Furkannn/senior-design/4. PDR/PDR - Version 1.pptx

## Head Controlled Human Interface Device for Users With Limited Hand Movement

Georgia Institute of Technology
School of Electrical and Computer Engineering
Augmented Comm Group
Roberto Pereira
Seth Stewart
Jarius Tillman
Sarvagya Vaish
March 14, 2013

## Project Overview

Human Interface Device
  - Alternative to current standard interface devices
  - Spinal cord injury or limited hand mobility patients.
Estimated Cost:

IMU | $100
Arduino | $ 50
Small Parts | $15
OFS | Donated
PCB | Donated
PLastic Housing | Donated
Total Cost | $165

Notes: Reduce wordiness to key points, speaker will elaborate
Cost ==

## Objectives

Complete prototype device:
-Fully functioning mouse movement using Pitch and Yaw head movements.
- Left and right click using facial gestures such as eyebrow raises.
- Integrate components into a small wearable device.

## Current Status

- Parts have been received
- A program has been implemented to translate the x-y displacement of the IMU (shown in video)
- 3D-printed a model to test the pcb,lens,OFS configuration
- Still working on translating the data from IMU/OFS to computer

## Video of working motion

Add video from Survy's Dropbox?

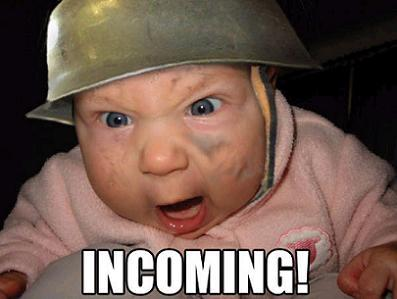
[picture p24: figure]

## Block Diagram

Block diagram from proposal

## Technical Approach

Arduino interfaces using SPI for OFS and IMU.
Retreive the x-y displacement registers on OFS at (speed).
IMU streams yaw, pitch, and roll using code. (Survy how?)
PICTURE?

## Logic Flow Chart(from proposal)

-This is how the device makes decisions to move the mouse.

## In-depth Review

Problems:
OFS part acquisition
Integrated mounting of OFS and IMU

Notes: In-depth review of the design, including problems/challenges/issues (you don’t have to present solutionsto the problems, but you can)

## Project Schedule(specific dates)

Get correct results from OFS
Get wouse code incorporated with to recognize the facial gestures
