Furkannn/senior-design/3. Project Summary Draft/Project Summary Working Draft - Augmented Comm.pdf

## ECE4007 Project Summary

Project Title | Augmented Communication Device
Team Members (names and majors) | Roberto Pereira – Computer Egineering

Seth Stewart – Computer Egineering

Jarius Tillman – Computer Egineering

Sarvagya Vaish – Computer Egineering

Advisor / Section | Dr. Arthur Koblasz – L04
Semester | 2009 Spring Intermediate or Final

Project Abstract

### (250-300 words)

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

Project Title | Augmented Communication Device

### List codes and

standards that

### significantly affect your project. Briefly describe how they influenced

your design.

| The Augmented Communication Device will make use of the following standards for general electrical safely: • OSHA 1910.335(a)(1)(iv): Employees shall wear nonconductive head protection wherever there is a danger of head injury from electric shock or burns due to contact with exposed energized parts • OSHA 1910.335(a)(1)(v): Employees shall wear protective equipment for the eyes or face wherever there is danger of injury to the eyes or face from electric arcs or flashes or from flying objects resulting from electrical explosion • With the ground wire disconnected, the chassis leakage is limited to 100 uA and the patient lead leakage must not exceed 50 uA The group decided to design a non-conductive casing for the device in order to meet these OSHA standards.
| The Augmented Communication Device will make use of the following standards for intra and inter device communication: • USB HID (Human Interface Device) Class interface for mouse communication • Inter-Integrated Circuit (I2C) protocol between the Inertial Momentum Unit and the ARM microprocessor • Serial Peripheral Interface (SPI) protocol between the optical flow sensor and the ARM microprocessor and between the ARM processor and the USB controller
| The following programming languages will be used for data processing and communication: • C for all microcontroller operations, for instance obtaining data from the sensors, processing IMU data, communicating the cursor movements to the host computer • Python to interface with the Wouse library to process the data received from the microcontroller • USB protocol was chosen for the interface between the device and the computer due to its widely available documentation, ease of use and conventionality. All current computers come with USB ports.

### List at least two significant realistic

design constraints that
applied to your project.

### Briefly describe how they affected your

design.

- Cost: Limited budget of $170 to design a prototype of the system.
- Time: There is a temporal constraint on the setup time. The Wouse system uses a support vector machine algorithm, which requires training data to develop a model to classify different facial gestures. The training time might be as long as 10-15 minutes and must be collected on a per user basis.

### Briefly explain two

significant trade-offs

### considered in your design, including options considered and

the solution chosen.

- Processing: The Augmented Communication Device would need to have a small response time for a seamless experience for the user. The response time is based on the processing of the Optical Flow Sensor data, mapping of the accelerometer data to cursor movements and the speed of communication between the device and the computer. We are proposing to do all processing on the microcontroller on the device. If this increases the lag beyond the proposed 300ms, we will consider the alternative of moving the processing from the microcontroller to the computer.
- Wired vs Wireless: There was also a decision for the team to focus on a wired USB interface instead of transmitting a wireless signal. This allows for simplification of the system since USB would be able to provide onboard power. Consequently, the team does not need to focus on power management.

### Briefly describe the

computing aspects of
your projects,

### specifically identifying

hardware-software
tradeoffs, interfaces,
and/or interactions.

Complete if applicable;

### required if team includes

CmpE majors.

- Inputs
- Head movement data using the IMU
- Facial gestures like wincing and eyebrow raises using the OFS
- Outputs
- Cursor commands identical or identifiable by a Linux OS

An Arduino microcontroller will obtain data from both the IMU and an OFS using serial communication. It will then process the data to recognize head movement and facial gestures and send the computer a signal using the USB HID protocol to resemble a mouse. In case that the Arduino microcontroller is the bottleneck in the processing stage, the data will be loaded onto the user’s host device and processed by custom software. The software created for the device will then send signals to move the cursor to the operating system.
The program will largely use C with the Arduino libraries for interfacing, but USB HID software will be needed as well.

## ECE4007: International Program

(Only groups with one or more International Program participants need to complete this page)

Project Title

### Global Issues (Less than one page)

(10 point font, single spaced)
