Furkannn/senior-design/2. Proposal/L23_Pricing_Worksheet.xls

Sheet: Blank
Example of Cost and Price Calculations
Fringe Benefits | 0% | of labor
Overhead | 0% | of materials, labor & fringe
Sales Expense | 0% | of selling price
Development Cost
What it costs the company to develop the product
Parts | 0
Labor | 0
Fringe Benefits, % of Labor | 0
Subtotal | 0
Overhead, % of Matl, Labor & Fringe | 0
Total | $0
Determination of Selling Price
What the customer pays the company for the finished product
Based on: | 1 | units
Parts Cost | 0
Assembly Labor | 0
Testing Labor | 0
Total Labor | 0
Fringe Benefits, % of Labor | 0
Subtotal | 0
Overhead, % of Matl, Labor & Fringe | 0
Subtotal, Input Costs | 0
Sales Expense | 0
Amortized Development Costs | 0
Subtotal, All Costs | 0
Profit | 0
Selling Price | $0
Note: Enter your data into the bold, italized cells

Sheet: Example
Example of Cost and Price Calculations
Fringe Benefits | 30% | of labor
Overhead | 120% | of materials, labor & fringe
Sales Expense | 10% | of selling price
Development Cost
What it costs the company to develop the product
Parts | 62
Labor | 28
Fringe Benefits, % of Labor | 8.4
Subtotal | 98.4
Overhead, % of Matl, Labor & Fringe | 118.08
Total | $216.48
Determination of Selling Price
What the customer pays the company for the finished product
Based on: | 1000 | units
Parts Cost | 62
Assembly Labor | 28
Testing Labor | 14
Total Labor | 42
Fringe Benefits, % of Labor | 12.6
Subtotal | 116.6
Overhead, % of Matl, Labor & Fringe | 139.92
Subtotal, Input Costs | 256.52
Sales Expense | 30
Amortized Development Costs | 0.21648
Subtotal, All Costs | 286.73648
Profit | 13.26352
Selling Price | $300
Instructions for using this spread sheet:
1. Input fringe benefit percentage (30% is typical for a large company)
2. Input overhead (120% is typical for a large company)
3. Input selling expense (10% is typical for a large company)
4. Input parts/material cost to develop
5. Input actual labor costs to develop (2000 hours in typical man-year)
6. Input number of units to manufacturer
7. Input parts/material costs per unit
8. Input assembly labor per unit
9. Input testing labor per unit
10 Input a selling price
Finally, view the profit for each unit sold
