Furkannn/senior-design/Logistics/Capstone Expo_Facilities Form - Augmented Comm Team.pdf

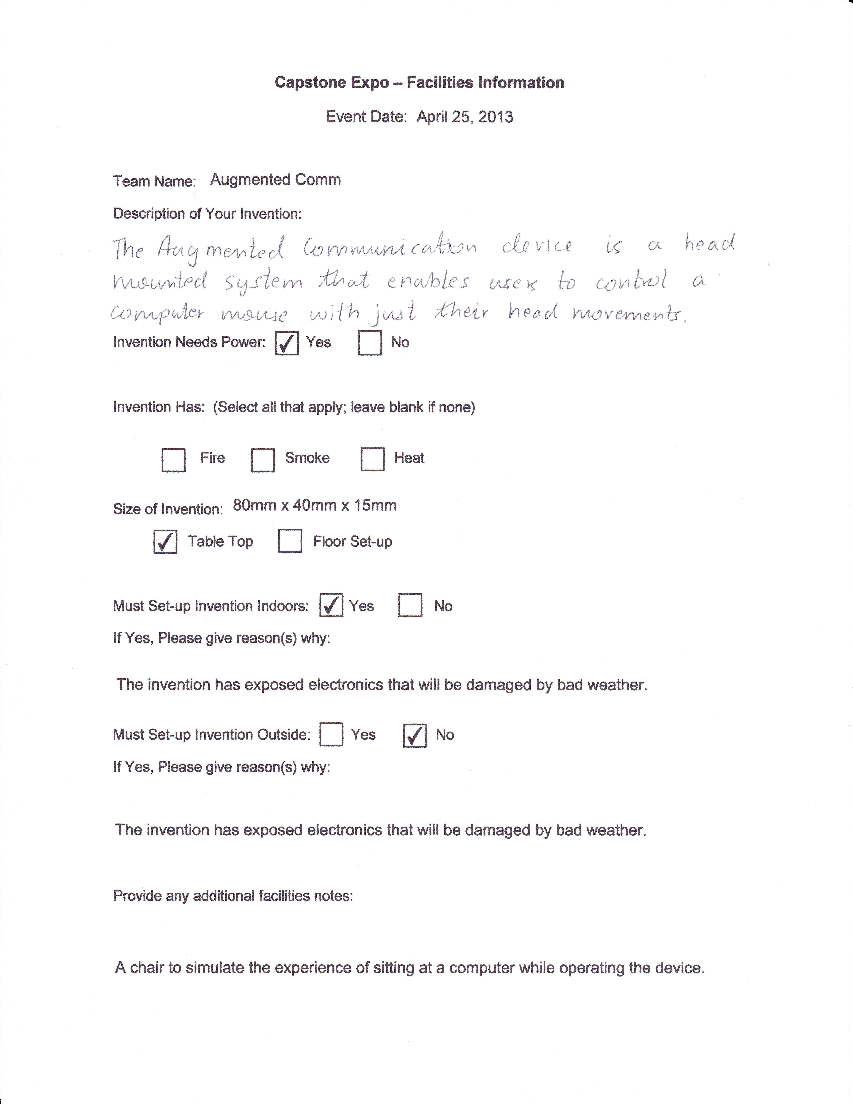
[picture p25: page 1]
