Furkannn/senior-design/2. Proposal/2013 Team Registration Form (ECE).xlsx

Note: For those teams that are interdisciplinary: If team members represent 50/50 of a discipline, then pick one to be listed and include this discipline in Column D. If over 50% of team members are for one discpline, the majority will be your discipline and this should be listed in Column D
Team Number (Make note of team # below; will need it in future) | Team Name | Team Members (project mgr listed 1st) | Department | Professor | Sponsor (if any) | Need Power (Y/N) | Does your project have to be inside (Y/N) | Project deals with Heat, Fire, Smoke, Water (List which, if any; expect these types of projects to be outside) | Brief Description of project | Email Address | T-shirt Sizes for ALL Team Members | Sandwich Choices for All Team Members (turkey, veggie)
1-Example | The Capstones | Mason Hollandbeck, Mark Ellington, Christine Esposito | ME | Dr. Rosen | Boeing | Y | N | N/A | This is a test to see how well directions can be followed | mason.hollandbeck@me.gatech.edu | 2 Med, 1 Sm | 2 Turkey and 1 veggie
47 | WatchDog |  | ECE |  |  |  |  |  |  | rhumphrey3@gatech.edu
48 | Medication Tray |  | ECE |  |  |  |  |  |  | ashah46@gatech.edu
49 | Buzzister |  | ECE |  |  |  |  |  |  | jli302@gatech.edu
50 | Augmented Comm | Sarvagya Vaish, Roberto Pereira, Seth Stewart, Jarius Tillman | ECE | Dr. Koblasz |  | Y | Y |  | The Augmented Communication Device is a head mounted system that enables users to control a computer mouse with just their head movements. | sarvagyavaish@gatech.edu | 2XL, 2SM | 4 Turkey
51 | Smart Locks |  | ECE |  |  |  |  |  |  | kdietze3@gatech.edu
52 | BME Biotracking |  | ECE |  |  |  |  |  |  | IlyaKhorosh@gatech.edu
53 | BME Adaptive Gaming |  | ECE |  |  |  |  |  |  | ceseim@gatech.edu
54 | BME Blood Glucose |  | ECE |  |  |  |  |  |  | sda3@gatech.edu
55 | BME Joint IV |  | ECE |  |  |  |  |  |  | clarkerr13@gatech.edu
56 | BME MultiIV |  | ECE |  |  |  |  |  |  | gbaum3@gatech.edu
57 | BME Patient Call |  | ECE |  |  |  |  |  |  | olasaki3@gatech.edu
58 | BME SmartPump |  | ECE |  |  |  |  |  |  | amcnair6@gatech.edu
59 | Accel Music |  | ECE |  |  |  |  |  |  | jaffe@gatech.edu
60 | Psycho Acoustics |  | ECE |  |  |  |  |  |  | amorgan9@gatech.edu
61 | Safe Helmet |  | ECE |  |  |  |  |  |  | mversteeg3@gatech.edu
62 | Smart Faucet |  | ECE |  |  |  |  |  |  | JamesKim@gatech.edu
63 | Stompbox |  | ECE |  |  |  |  |  |  | kajal_rahimian@gatech.edu
64 | Bat Hitting |  | ECE |  |  |  |  |  |  | blee78@gatech.edu
65 | DC Sputterer |  | ECE |  |  |  |  |  |  | adriskell6@gatech.edu
66 | ME KinectaMower |  | ECE |  |  |  |  |  |  | mjenkins9@gatech.edu
67 | SO COMM-RADES |  | ECE |  |  |  |  |  |  | steve.fernando@gatech.edu
68 | Audio Virtualization |  | ECE |  |  |  |  |  |  | mcohen9@gatech.edu
69 | Helmet Heads |  | ECE |  |  |  |  |  |  | jknight32@gatech.edu
70 | Lazy Boys |  | ECE |  |  |  |  |  |  | dmccarthy9@gatech.edu
71 | Terminis Robot |  | ECE |  |  |  |  |  |  | cmcmillan7@gatech.edu
72 | Guitar Effects |  | ECE |  |  |  |  |  |  | tfultz@gatech.edu
73 | Space Solar Power |  | ECE |  |  |  |  |  |  | fbejar7@gatech.edu
74 | Wireless Temp |  | ECE |  |  |  |  |  |  | rwilliams87@gatech.edu
75 | RoboBear |  | ECE |  |  |  |  |  |  | jlam3@gatech.edu
76 | RF Harvesting |  | ECE |  |  |  |  |  |  | mtrepanier3@gatech.edu
77 | RFID Pacemaker |  | ECE |  |  |  |  |  |  | bcallaway6@gatech.edu
78 | ECM |  | ECE |  |  |  |  |  |  | hunter.scott@gatech.edu
79 | Neuro Sphere |  | ECE |  |  |  |  |  |  | mkachalov3@gatech.edu
80 | Cap Touch Pad |  | ECE |  |  |  |  |  |  | mhuang40@gatech.edu
81 | Crosswalk |  | ECE |  |  |  |  |  |  | jreedy3@gatech.edu
82 | Energy Harvesters |  | ECE |  |  |  |  |  |  | fpenangwala3@gatech.edu
83 | Pyrexia |  | ECE |  |  |  |  |  |  | osama@gatech.edu
84 | KinectaBot |  | ECE |  |  |  |  |  |  | alam1243@gatech.edu
85 | PUMA |  | ECE |  |  |  |  |  |  | cjohnston8@gatech.edu
86 | RC Combat |  | ECE |  |  |  |  |  |  | jholliday7@gatech.edu
87 | SouthEastCon |  | ECE |  |  |  |  |  |  | espring3@gatech.edu
88 | Sea DUUC |  | ECE |  |  |  |  |  |  | elorie3@gatech.edu
89 | Sailboat |  | ECE |  |  |  |  |  |  | Elliot.Newnham@gatech.edu
90 | Milling Machine |  | ECE |  |  |  |  |  |  | askomorokhova3@gatech.edu
91 | VIP |  | ECE |  |  |  |  |  |  | kbaumanis3@gatech.edu
