Furkannn/senior-design/2. Proposal/Pictures/Block Diagram.jpg

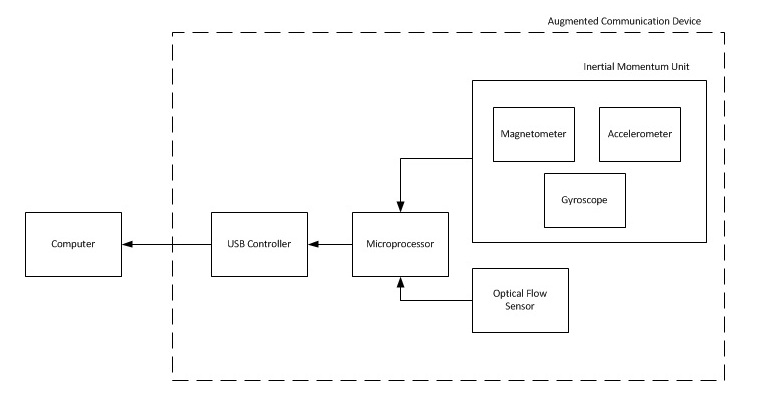
2. Proposal/Pictures/Block Diagram.jpg
