Furkannn/senior-design/2. Proposal/Pictures/bluetooth near eye_project description 3.jpg

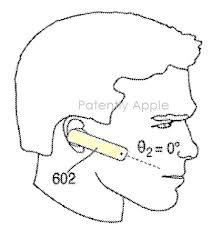
2. Proposal/Pictures/bluetooth near eye_project description 3.jpg
