Furkannn/senior-design/2. Proposal/Pictures/epic.jpg

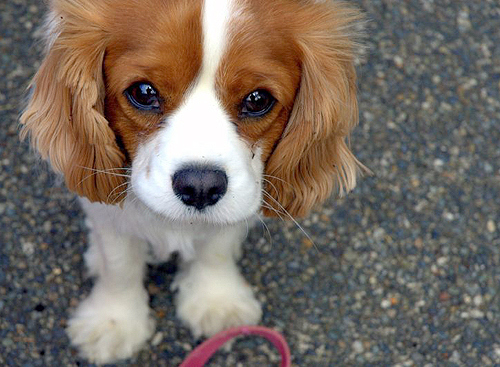
2. Proposal/Pictures/epic.jpg
