Furkannn/senior-design/2. Proposal/Pictures/head_rotation_project description.jpg

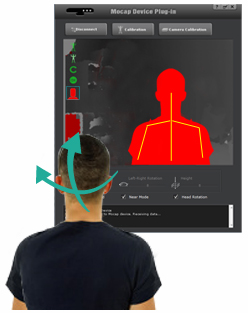
2. Proposal/Pictures/head_rotation_project description.jpg
