Furkannn/senior-design/2. Proposal/Pictures/headmouse-motivation.jpg

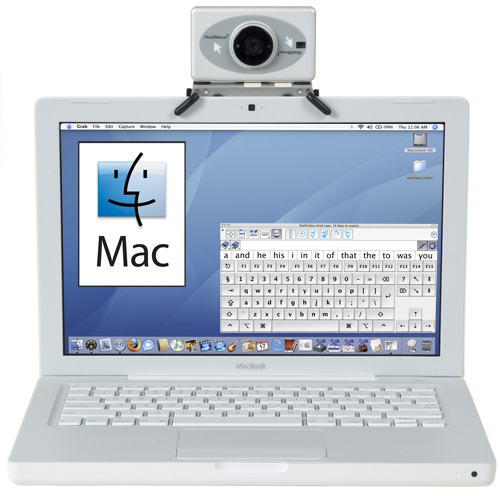
2. Proposal/Pictures/headmouse-motivation.jpg
