Furkannn/senior-design/2. Proposal/Pictures/Motivation - existing work 1.2.png

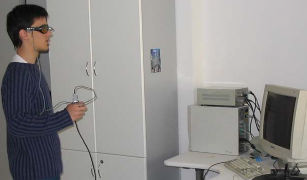
2. Proposal/Pictures/Motivation - existing work 1.2.png
