Furkannn/senior-design/2. Proposal/Pictures/Motivation - existing work 2.1.png

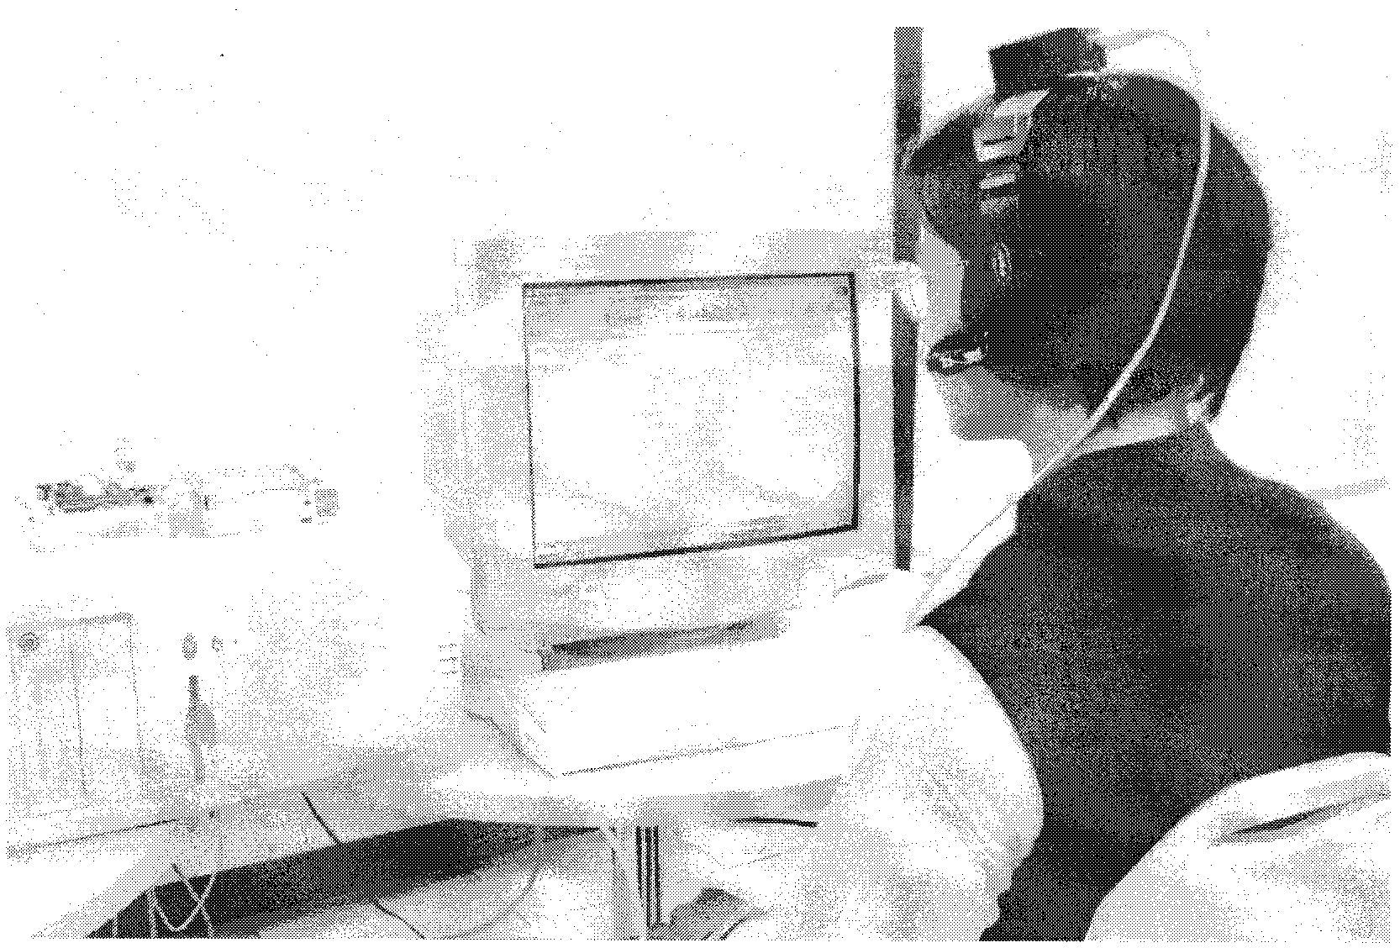
2. Proposal/Pictures/Motivation - existing work 2.1.png
