Furkannn/senior-design/2. Proposal/Pictures/project description - head  roll pitch yaw 3.jpg

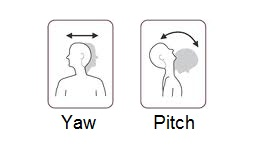
2. Proposal/Pictures/project description - head roll pitch yaw 3.jpg
