Furkannn/senior-design/2. Proposal/Pictures/project description - head  roll pitch yaw.jpg

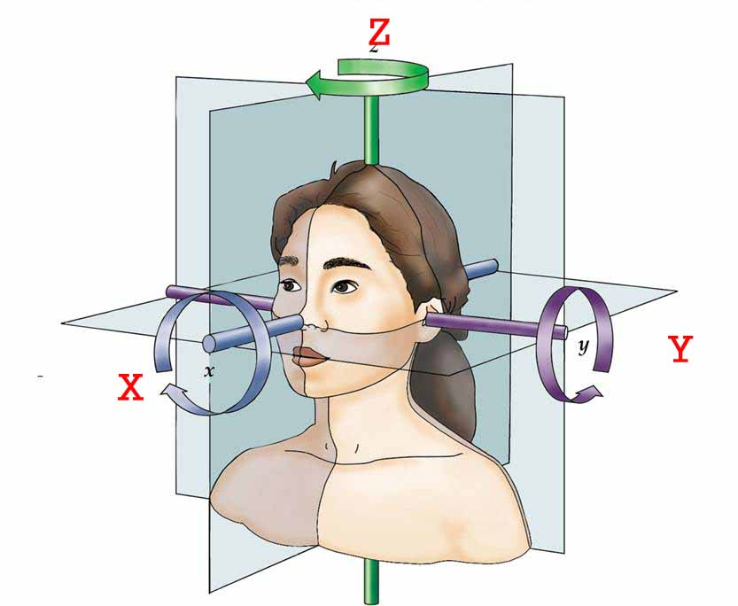
2. Proposal/Pictures/project description - head roll pitch yaw.jpg
