Furkannn/senior-design/2. Proposal/Pictures/puffed cheek_background.jpg

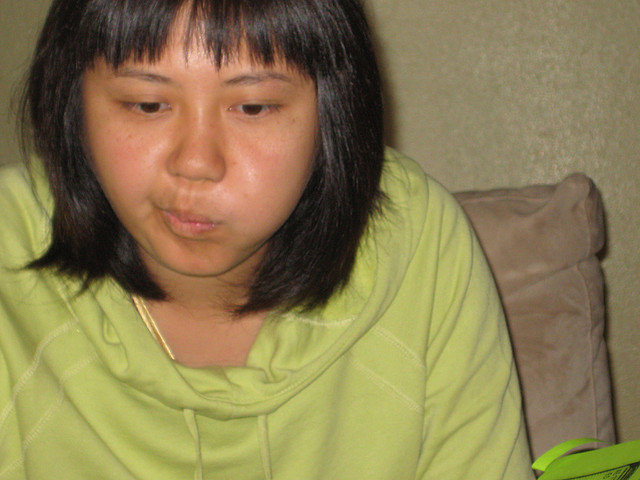
2. Proposal/Pictures/puffed cheek_background.jpg
