Furkannn/senior-design/2. Proposal/shiftedganttchart.JPG

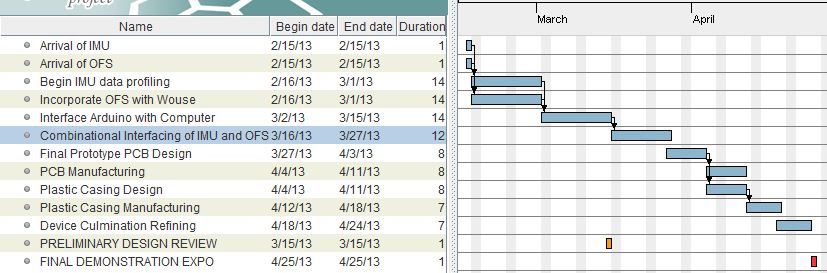
2. Proposal/shiftedganttchart.JPG
