Furkannn/senior-design/4. PDR/3-11.2.jpg

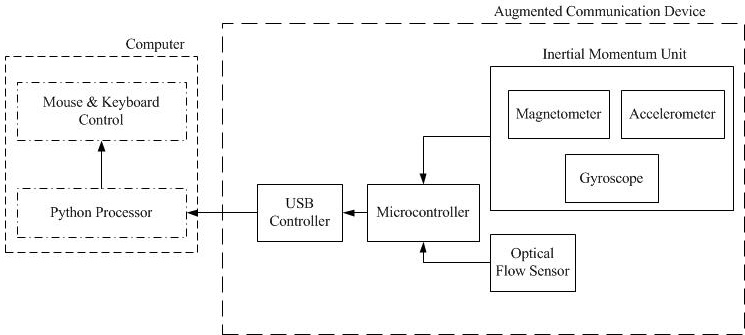
4. PDR/3-11.2.jpg
