Furkannn/senior-design/4. PDR/bite_switch.jpg

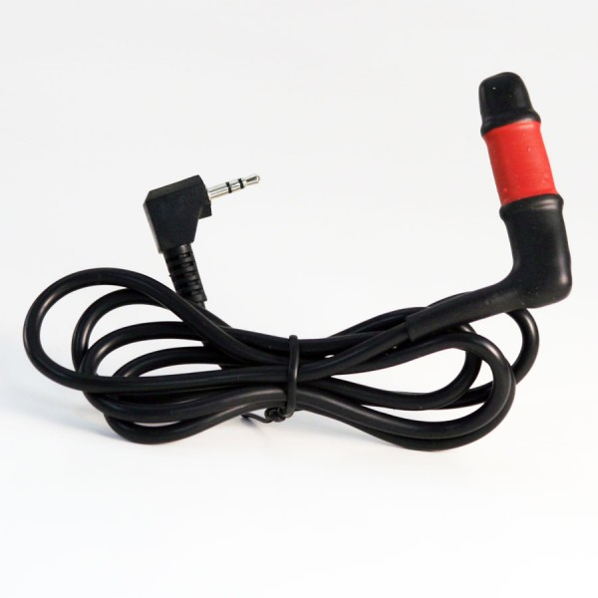
4. PDR/bite_switch.jpg
