Furkannn/senior-design/4. PDR/computer_monitor.jpg

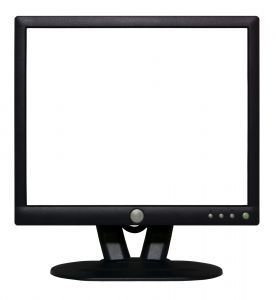
4. PDR/computer_monitor.jpg
