Furkannn/senior-design/4. PDR/cursor.jpg

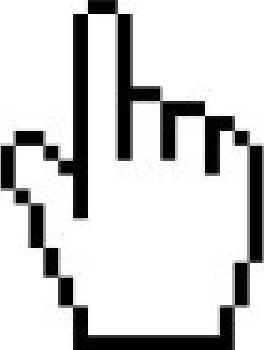
4. PDR/cursor.jpg
