Furkannn/senior-design/4. PDR/head-tracking-equations.jpg

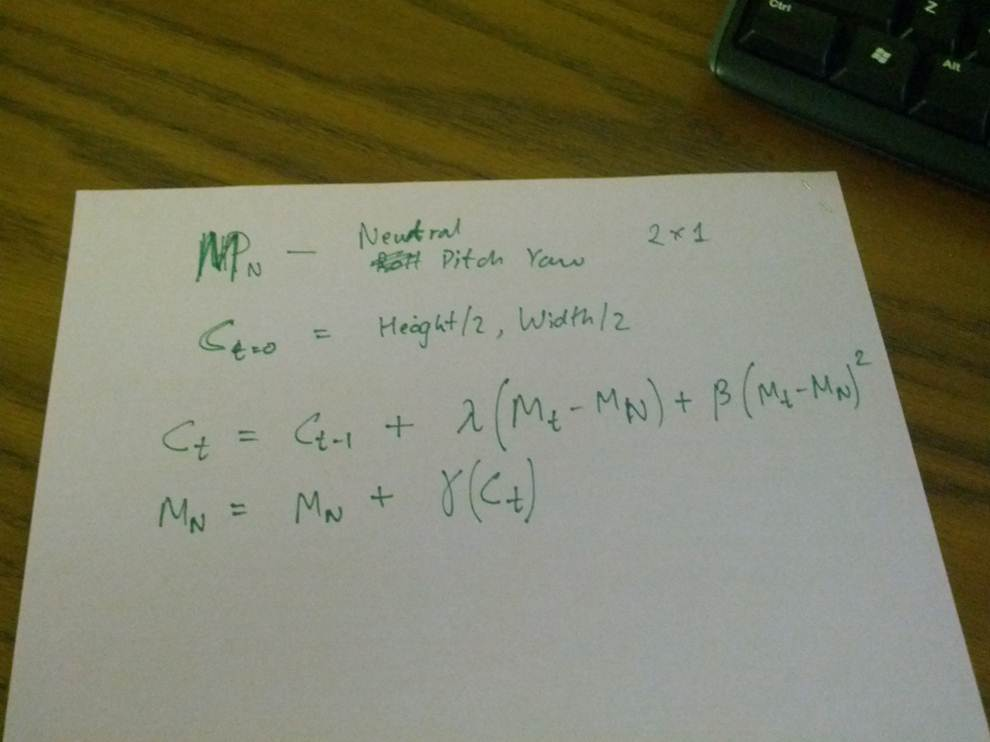
4. PDR/head-tracking-equations.jpg
