Furkannn/senior-design/4. PDR/Modified Flow Diagram.JPG

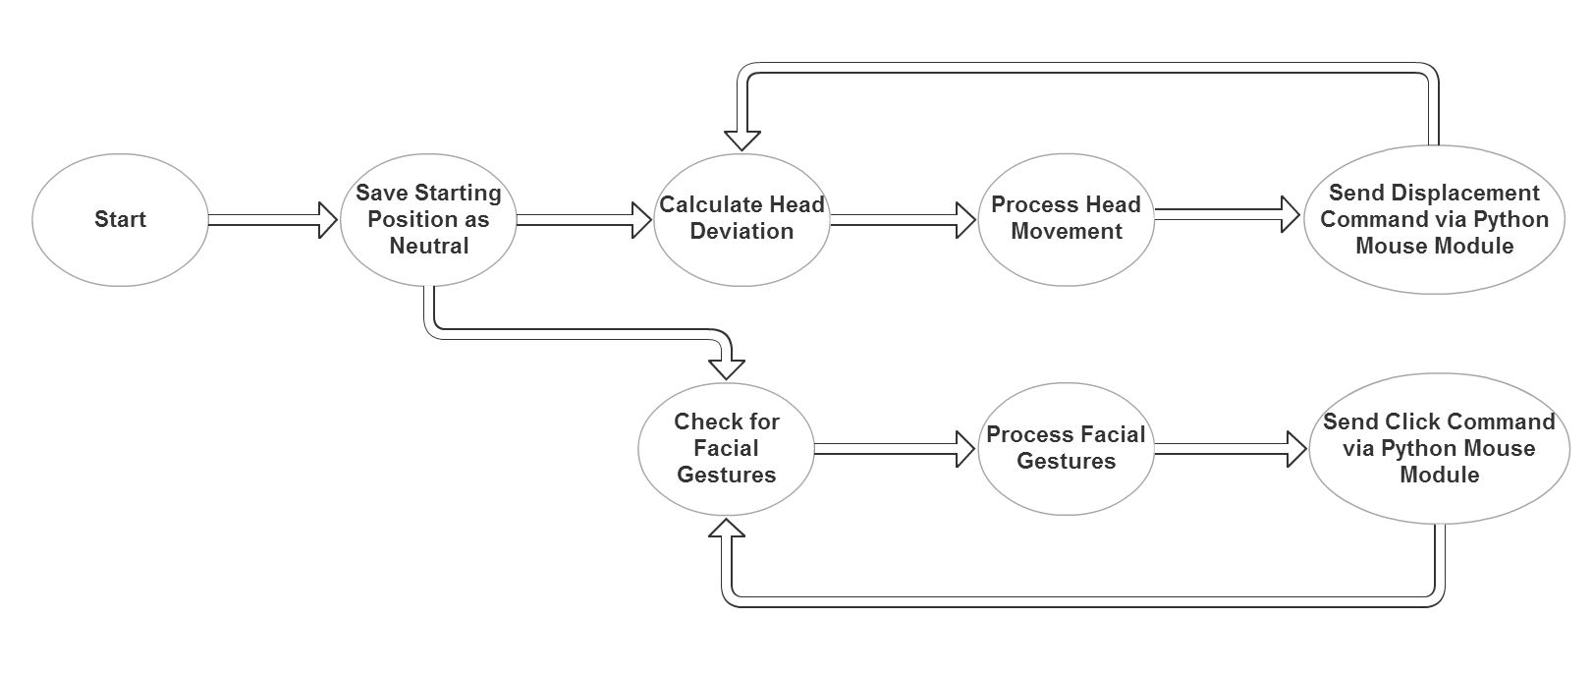
4. PDR/Modified Flow Diagram.JPG
