Furkannn/senior-design/4. PDR/OFSBoardModified.bmp

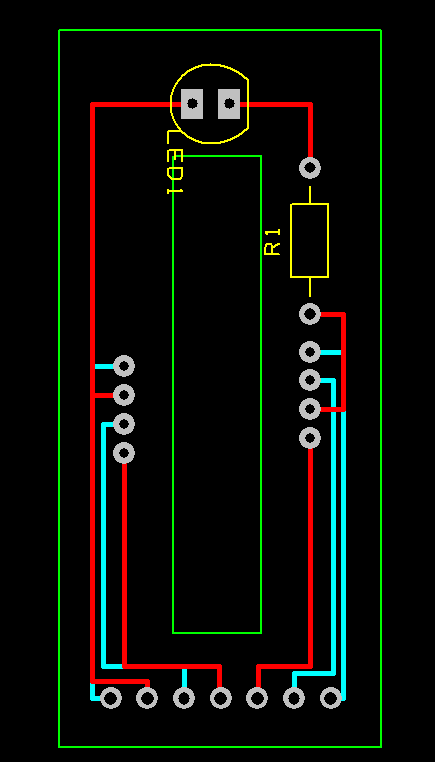
4. PDR/OFSBoardModified.bmp
