Furkannn/senior-design/4. PDR/pcb - circuit.JPG

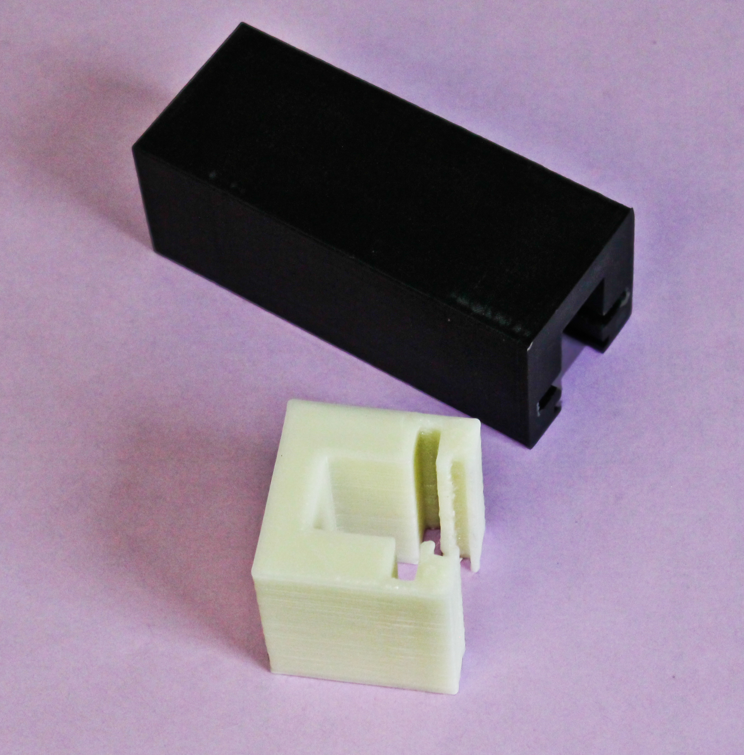
4. PDR/pcb - circuit.JPG
