Furkannn/senior-design/4. PDR/pcb - physical.JPG

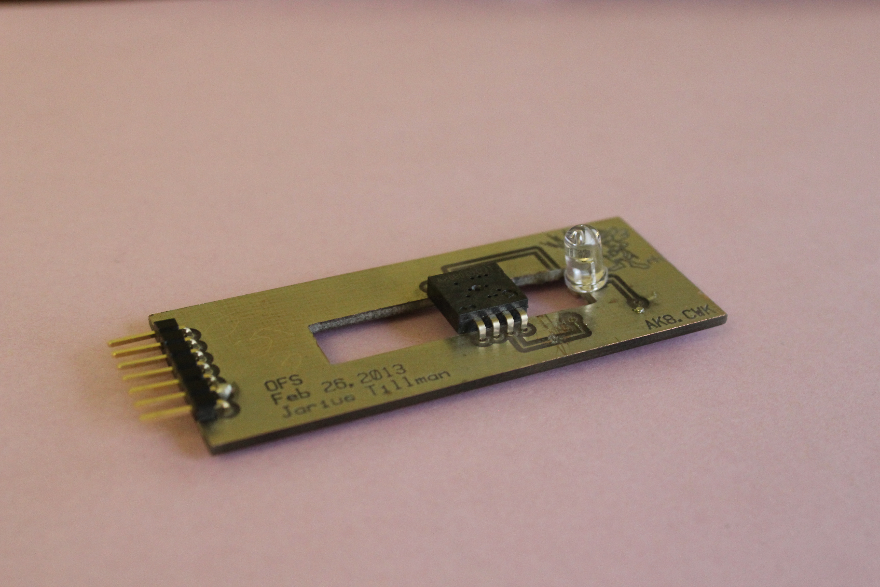
4. PDR/pcb - physical.JPG
