Furkannn/senior-design/4. PDR/raise-eyebrow-o.gif

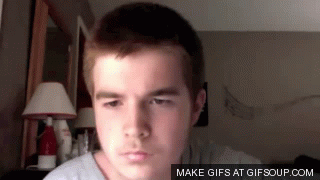
4. PDR/raise-eyebrow-o.gif
