Furkannn/senior-design/6. Poster/Block Diagram.jpg

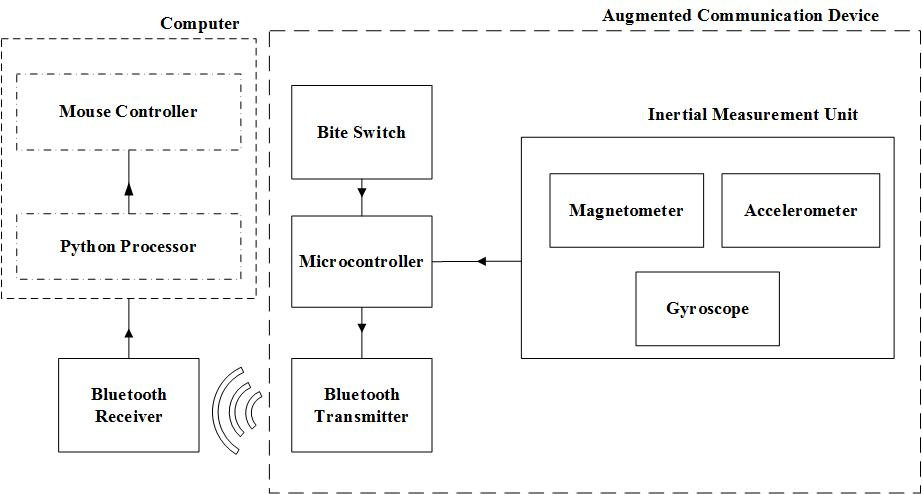
6. Poster/Block Diagram.jpg
