Furkannn/senior-design/6. Poster/Control Diagram.jpg

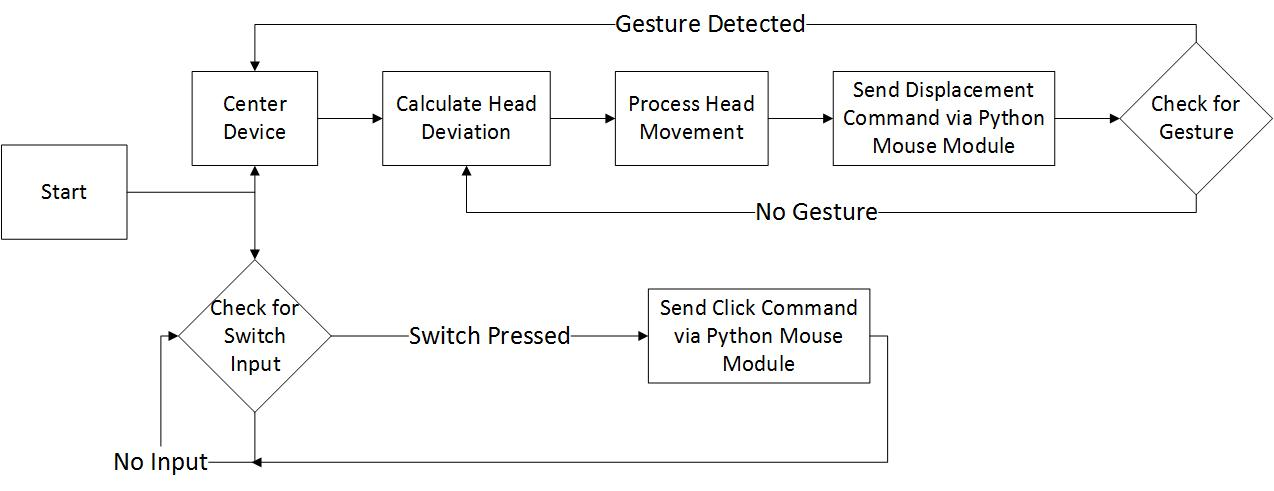
6. Poster/Control Diagram.jpg
