Furkannn/senior-design/6. Poster/UI.png

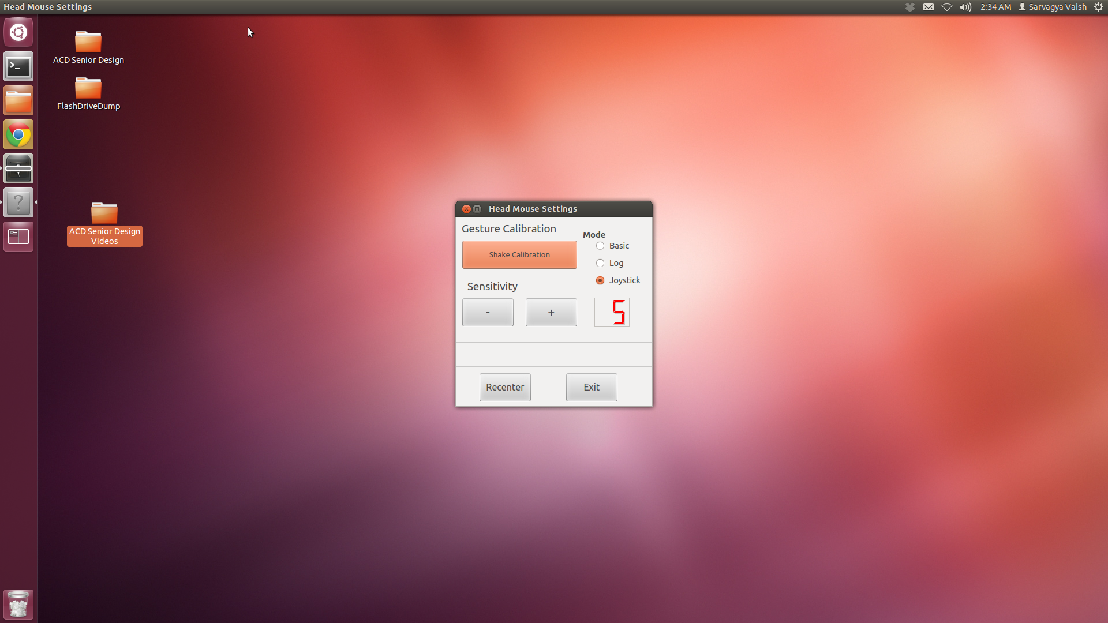
6. Poster/UI.png
