Furkannn/senior-design/PCB Design/Box PCB/10724-03b.jpg

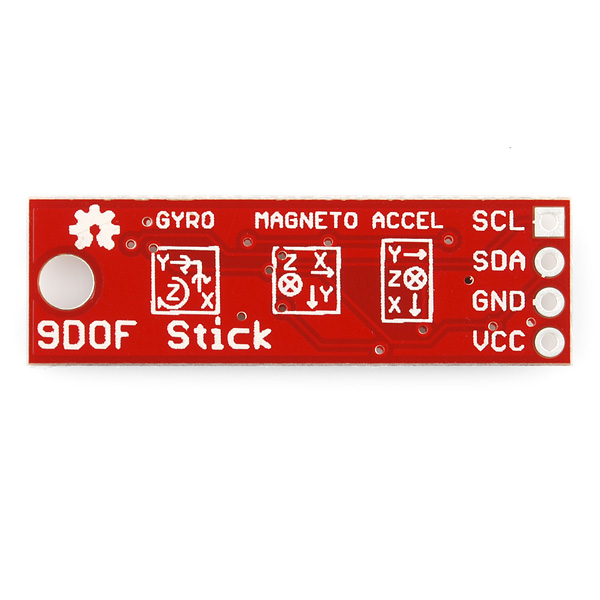
PCB Design/Box PCB/10724-03b.jpg
