Furkannn/senior-design/PCB Design/Box PCB/11113-03d.jpg

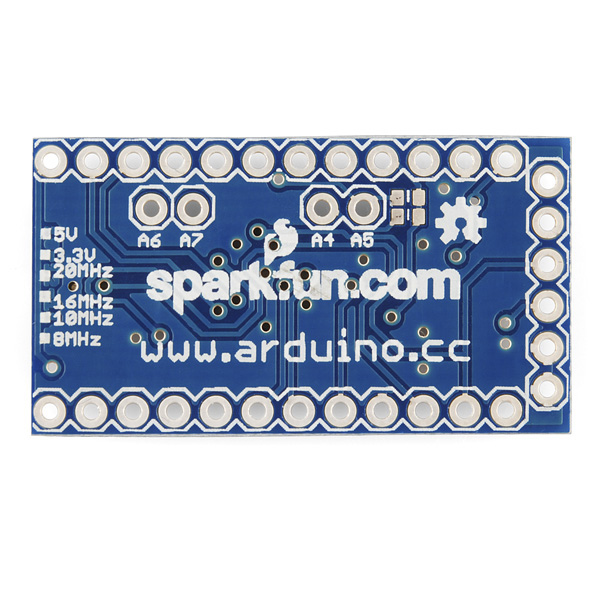
PCB Design/Box PCB/11113-03d.jpg
