Furkannn/senior-design/PCB Design/Box PCB/sku_104299_3.jpg

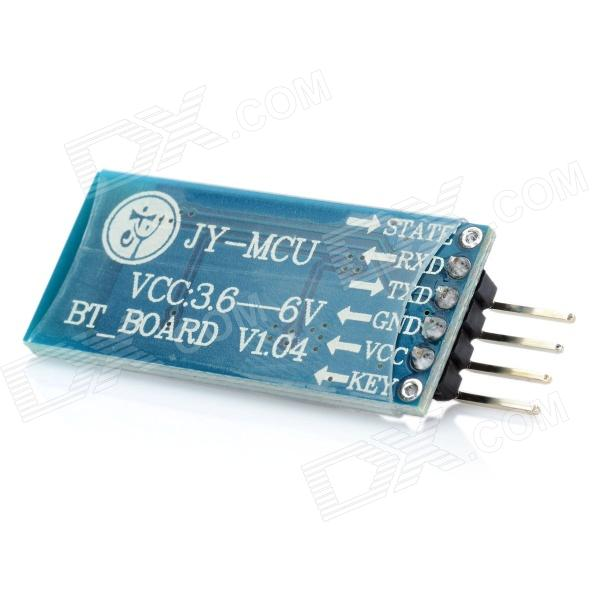
PCB Design/Box PCB/sku_104299_3.jpg
