Furkannn/senior-design/Python Scripts/headMouse/MouseFSM_v2/graph_shake.png

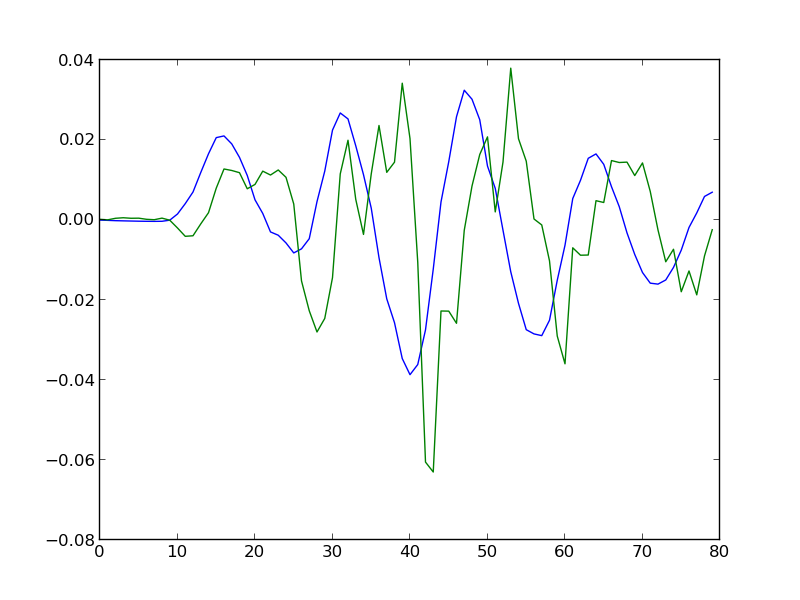
Python Scripts/headMouse/MouseFSM_v2/graph_shake.png
