Furkannn/senior-design/Python Scripts/headMouse/PCA/graph_left_nod.png

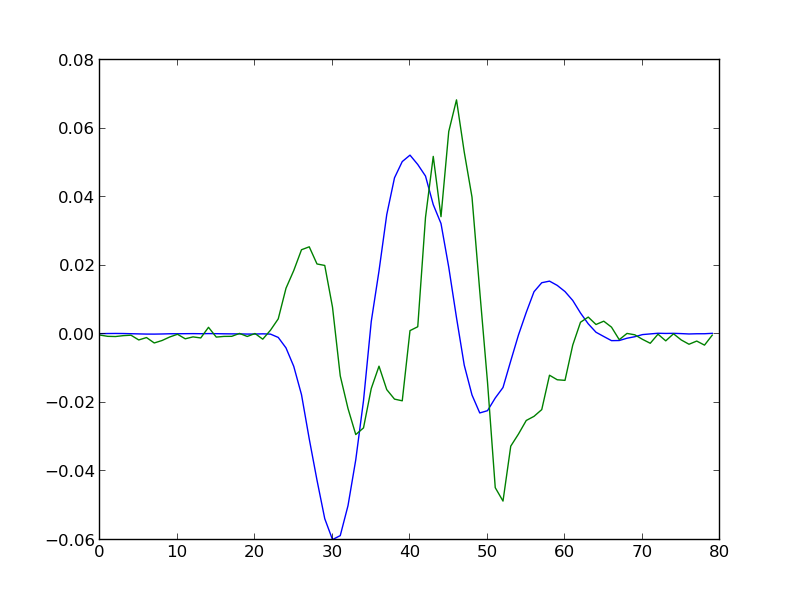
Python Scripts/headMouse/PCA/graph_left_nod.png
