Furkannn/senior-design/Python Scripts/headMouse/PCA/graph_right_nod.png

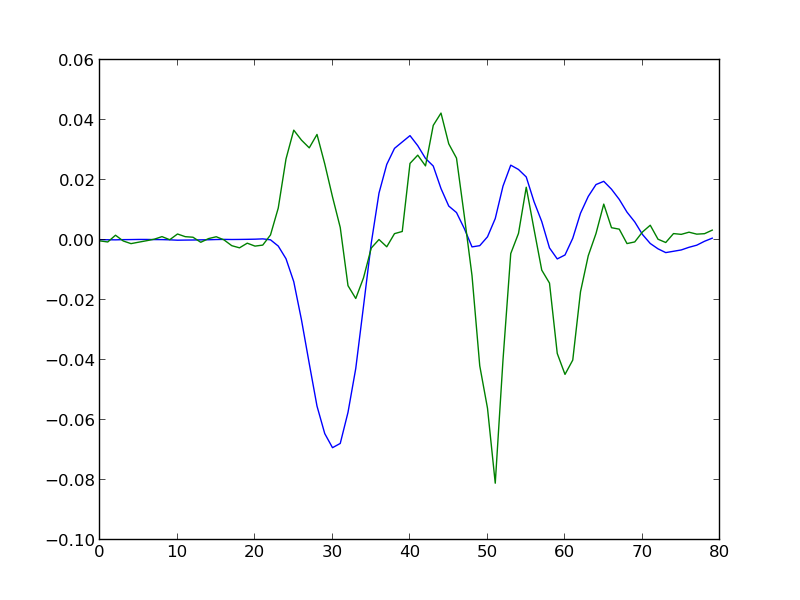
Python Scripts/headMouse/PCA/graph_right_nod.png
