Furkannn/senior-design/Solidworks/Ear Mount Design/Images/FullModel2.JPG

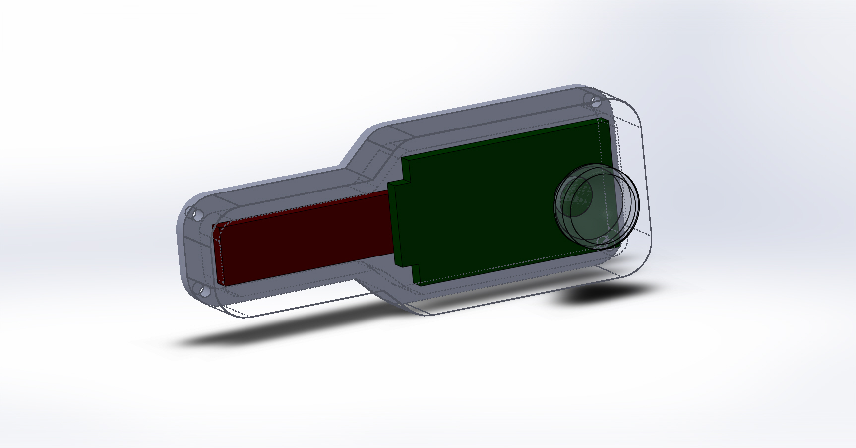
Solidworks/Ear Mount Design/Images/FullModel2.JPG
