Furkannn/senior-design/Solidworks/Ear Mount Design/Images/FullModel.JPG

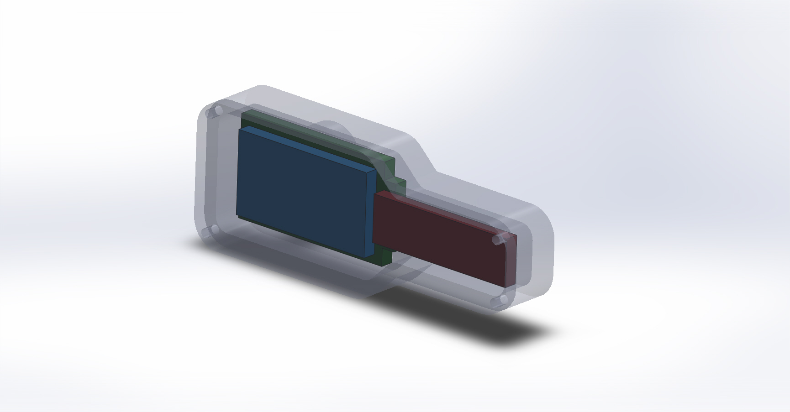
Solidworks/Ear Mount Design/Images/FullModel.JPG
