Furkannn/senior-design/Solidworks/Ear Mount Design/Modification.png

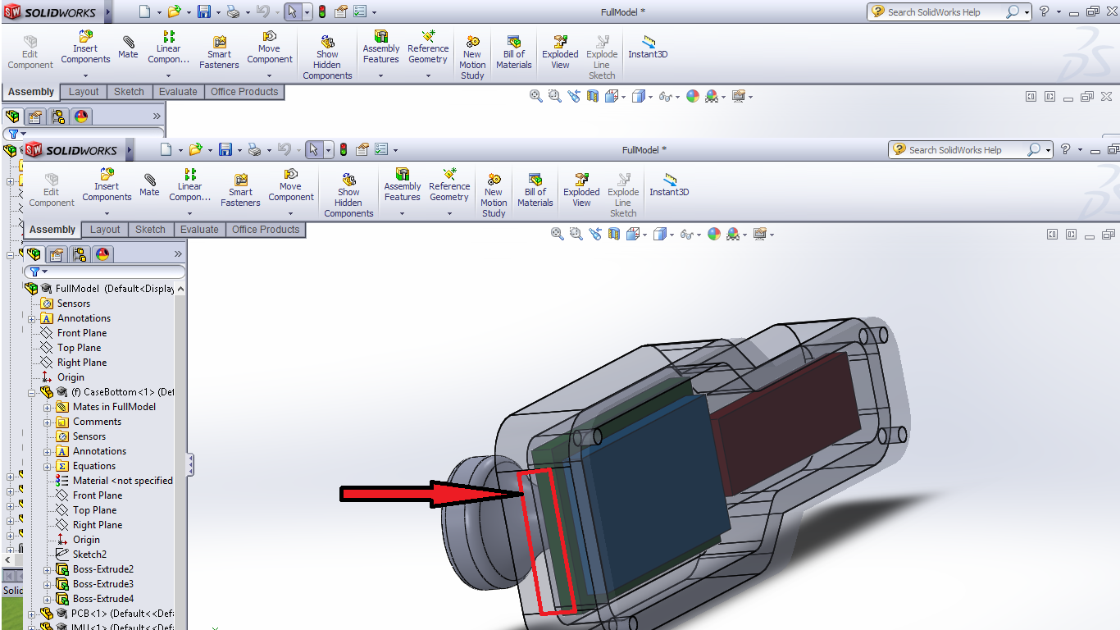
Solidworks/Ear Mount Design/Modification.png
