Furkannn/senior-design/2. Proposal/cost breakdown.docx

Table 2. Breakdown of Prototype Costs

Item | Cost
IMU | $99.95
ADNS | Donated
Arduino | $50.00
PCB | $20.00
Plastic Casing | Donated
TOTAL | $170.00
