Furkannn/senior-design/ECE 4007 Spring_2013 Parts Checkout Return List.xlsx

Parts Checked Out Return List
Group/Section # | Names | Date | Description / QTY | Model # | Serial #
Kinect-A-Bot- TM-2 ( L02 ) | Iftekhar Choudhury | 2013-04-04 | mbed | NXP LPC1768 | MBED-43256
Accelerated music- BH1 (L05) | Jennifer Newsham | 2013-02-21 | 5v ready Micro-SD Breakout board
 |  | 2013-02-14 | Computer speakers | Harman/Kardon | 06941V
Wireless Speakers- MW-1 ( L04) | Juan de Cardenas | 2013-02-19 | HDMI-DVI Adapter
SEA DUUC- WS-2 ( L01 ) | Randall Williford | 2013-03-06 | mbed
 |  |  | RS232 gender changer
 |  |  | Sparkfun RS232 to TTL Converter
 |  |  | Female to female RS232 Cord
Pyrexia- OB-4 ( L05 ) | Victor Yusuf | 2013-03-06 | Arduino uno
 |  | 2013-03-04 | Microstick II
Energy Harvesters- OB3 (L05) | Drew Baker | 2013-02-14 | 16 Bit breakaway temp sensor | MAX11213
SouthEastCon- WS-1 (L01) | Andrew Vaziri | 2013-01-25 | Beagle Bone
 |  |  | Sharp ZY0A02 x4
 |  |  | Sharp GP2DIS0A x 2
Neuro Sphere- MW-7 (L04) | Matias Almada | 2013-01-31 | EPOC EEG Headset/SDK x2 | Research edition
Sailboat- WS-3 (L01) | Trevor Green | 2013-02-04 | Xbee Radio x1 | Series 2
 |  |  | Xbee breakout boards x4
 |  |  | Gyroscope
 |  |  | IR Range finder | 2Y0A02
 |  |  | BlueSmirf Serial Bluetooth Module |  | T9J-RN42
 |  |  | Xbee Xplorer | xBee RS232
 |  |  | Compass- Sparkfun | LSM303
 |  |  | 3-Axis Accelerometer | ADXL335
RC Combat- TM-4 (L02) | Richard Nguyen | 2013-02-07 | Arduino Duemilanove |  | S1396
 |  |  | Servo motor- Parallax
 |  |  | Extra Arduino chip
Robogear-MW-3 (L04) | Jaison George | 2013-02-08 | Arduino Mega |  | M00022198
 |  | 2013-03-25 | AC Adapter A31185C 10.8 VAC
 |  |  | Motor Driver Carrier | MC33926 | 1212
 |  |  | SGMADA DC Motor 12v | MR-3612700040KY | 11042300555
SAFE Helmet- BH-3 (L05) | John Herrmann | 2013-02-10 | Android Google Phone Nexus x2 | SPH-D720 | 8C71F8581933
 |  |  |  |  | 8C71F855E740
SoundTrack- MW-2 (L04) | Mackenzie Smith | 2013-02-08 | USB to serial
 |  |  | Xbee explorer
 | Vikrum Sheorey | 2013-03-04 | Xbee | 09P
 |  |  | Breakout board for Xbee
Heli- TM-1 (L02) | Chris Stolz | 2013-02-11 | Samsung Galaxy Tablet
BME Adaptive Gaming- BE-2 (L01) | Caitlyn Seim | 2013-02-17 | Arduino mega | ATMEGA328 | C03767
 |  |  | 345 3-Axis accelerometer |  | MMA7455
 |  |  | Arduino USB cord
 |  |  | Mbed |  | MBED-49266
Smart Faucet- BH-4 (L05) | Rhushikesh Bhadkamkes | 2013-03-13 | mBed | 005-1
 |  | 2013-03-04 | Stepper motor | S7ByGHM201 | 20100425
Therminbug- GD-3 (L01) | Keyvan Muvahhid | 2013-03-05 | SMA PCB Mount connector x2
SmartLocks- AK-5 (L04) | Kevin Dietze | 2013-03-04 | Linksys Wireless G Router | WRT54GS | CGN30E616002
 |  |  | IP Cam | NCB541W | X0008M032V
Wireless Speakers- MW-2 (L04) | Zia Drakhshaudeh | 2013-03-01 | Speaker
 |  |  | 2GB SD Card | Sandisk
 |  |  | Webcam | Logitech | 860-000228
Wireless Temp Sensors- GD-4 (L01) | Randy Caranza | 2013-03-04 | SMA Cable
 |  |  | Male to Male SMA Adapter
