Furkannn/senior-design/ECE4007_Spring_2013_Parts Purchase Return List.xls

ECE 4007 Spring 2013 Cost
Allotments: Prof. Smith, W. 9 groups $3,492.00 Approx. max. $ 388.00 ea.
Group # | Date |  | Items |  | Supplier
( L01 ) BME Adaptive Gaming ( BE-2 ) | 2013-02-15 |  | Wii Remote Control |  | Amazon.com
 | 2013-02-15 |  | Piezoelectric Film Sensors |  | Imagesco.com
 | 2013-02-15 |  | m-bed dev board |  | Sparkfun.com
 | 2013-02-15 |  | ADXL-345 Acceleromters |  | Robotshop.com
 | 2013-03-01 |  | Headsets |  | Amazon.com
 | 2013-03-01 |  | 100ft 16 Gauge Speaker Wire |  | Amazon.com
 | 2013-03-05 |  | Wii Remote Control |  | Amazon.com
 | 2013-03-05 |  | 1/8 TRS to 3 Pin XLR Adapter |  | Bestpricecables.com
 | 2013-03-19 |  | Turlte Beach Ear Force Gaming Headset |  | Amazon.com
 | 2013-03-28 |  | Joysticks |  | DX.com
 | 2013-03-28 |  | Ribbon Cable / Tactile Switch |  | Sparkfun.com
 | 2013-04-03 |  | WiFi Shield |  | Dexterindustries.com
 | 2013-04-11 |  | 5-Way Tactile Switch |  | Sparkfun.com
 | 2013-04-11 |  | Arduino Duemilanove |  | Amazon.com
( L01 ) Sea DUUC (WS-2 ) | 2013-02-04 |  | SATA Adapter Cable Kit |  | Amazon.com
( L01 ) Sailboat ( WS-3 ) | 2013-02-15 |  | E-Vane and Vortex Wind Sensor |  | Inspeedstore.com
 | 2013-04-11 |  | PCB Boards |  | Advanced Circuits
 | 2013-04-11 |  | PCB Boards |  | Advanced Circuits
 | 2013-04-11 |  | PCB Boards |  | Advanced Circuits
(L01 ) Drill Bits ( WS-4 )
(L01) VIP (WS-5)
(L02) BME Joint IV (BE-4) | 2013-03-01 |  | Peristaltic Pumps |  | Langerinstruments.com
 | 2013-03-01 |  | 16 GB MircoSD Card w/ Adapter |  | NewEgg.com
(L02) BME Patient Call (BE-5) | 2013-04-17 |  | Parallel Printer Cable |  | NewEgg.com
(L02) BME SmartPump (BE-6) | 2013-02-18 |  | Conn Plug Phone 1/4" Solder |  | Digi-Key.com
 | 2013-04-17 |  | DLP USB IO8 and IO 20 |  | Mouser.com
 | 2012-04-17 |  | 20CH Data Acquisition Board / 12 Bit IC DAQ |  | Digi-Key.com
(L04) BME Blood Glucose (BE-3) | 2013-02-15 |  | Wii Remote Control |  | Amazon.com
 | 2013-02-15 |  | mbed DEV-00564 |  | Sparkfun.com
(L05) SouthEastCon (WS-1) | 2013-02-04 |  | Programming -Computer-Vision-Python |  | Amazon.com
 | 2013-02-04 |  | IC Color Sensor |  | Digi-Key.com
 | 2013-02-04 |  | IR Range Sensor 4-30 cm |  | Robotshop.com
 | 2013-02-05 |  | Wheels / Mounting Hubs / Plastic Caster Ball |  | Pololu.com
 | 2013-02-06 |  | Force Sensitive Resistors |  | Sparkfun.com
 | 2013-02-12 |  | Plastic Caster Ball |  | Pololu.com
 | 2013-03-01 |  | BeagleBone Kit / BeagleBone DVID Audio Cape |  | Digi-Key.com
Allotments: Prof. Durgin, G. 4 groups $ 1,552.00 Approx. max. $388.00 ea.
Group # | Date |  | Items |  | Supplier
( L01 ) Guitar Effects ( GD-1 ) | 2013-03-05 |  | DO 440 Envelope Filter/Phase 90 RTS PCB/TubeScreamer PCB |  | Generalguitargadets.com
 | 2013-03-05 |  | D-8 FAB Guitar Effects Pedal |  | Musiciansfriend.com
 | 2013-03-05 |  | IC Switch Quad SPDT |  | Newark.com
 | 2013-03-05 |  | IC Switch Dual SPDT |  | Digi-Key.com
 | 2013-03-05 |  | Optocoupler Resistor |  | Newark.com
 | 2013-04-11 |  | PCB Boards |  | Advanced Circuits
 | 2013-04-11 |  | PCB Boards |  | Advanced Circuits
 | 2013-04-12 |  | Switching Power Supply |  | Jameco.com
 | 2013-04-12 |  | N-Channel JFET's TO-92 |  | Newark.com
( L01 ) Space Solar Power ( GD-2 ) | 2013-02-15 |  | Solar Cells / Charge Controller / Cables |  | WholesaleSolar.com
 | 2013-02-19 |  | Ant. Grid 5.8 GHz 27 dBi |  | I-Com.Com
 | 2015-02-19 |  | 5.8-8.5 GHz Wideband Amplifier |  | Digi-Key.com
 | 2013-04-03 |  | MC4 Branch Solar Cell Plugs +/- |  | Solarelectricdistributors.com
( L01 ) Theremin ( GD-3 ) | 2013-03-01 |  | Copper Tubing / Pipes / Plates |  | McMasterCarr.com
( L01 ) Wireless Temp ( GD-4 ) | 2013-02-12 |  | Box / Antennas / Thermisters |  | Digi-Key.com
 | 2013-03-01 |  | TW-ART Mount / Silicon |  | Amazon.com
 | 2013-03-01 |  | IC Temp Sensor |  | Digi-Key.com
 | 2013-03-21 |  | Temperature Sensor |  | Digi-Key.com
Allotments: Prof. James, K. 4 groups $ 1,552.00 Approx. max. $388.00 ea.
Group # | Date |  | Items |  | Supplier
( L02 ) Bat Hitting ( CJ-1 )
( L02 ) DC Sputterer ( CJ-2 )
( L02 ) ME KinectaMower ( CJ-3 )
( L02 ) SO COMM-RADES ( CJ-4 ) | 2013-02-12 |  | SMD to DIP Adpaters |  | Proto-Advantage.com
 | 2013-02-19 |  | SMT Adapter to DIP Adapter |  | Proto-Advantage.com
 | 2013-02-19 |  | Networking IC |  | Cdiweb.com
 | 2013-02-25 |  | QFN to 48 Dip Adapters |  | Proto-Advantage.com
 | 2013-03-06 |  | Crystal Clock Oscillators |  | Digi-Key.com
 | 2013-03-06 |  | Ethernet Jack |  | Mouser.com
 | 2013-03-26 |  | INGaAS Photodiode |  | Pmoptics.com
 | 2013-03-28 |  | EvaL Kit TXRX 650nm FE |  | Digi-Key.com
Allotments: Prof. Brand, O. 4 groups $1,552.00 Approx. max. $388.00 ea.
Group # | Date |  | Items |  | Supplier
( L02 ) Cap Touch Pad ( OB-1 ) | 2013-04-02 |  | Diodes / Amplifiers / Connectors / Etc. |  | Digi-Key.com
 | 2013-04-11 |  | PCB Boards |  | Advanced Circuits
 | 2013-04-11 |  | PIC KIT 3 Programmer / Jumper Wire Set
( L05 ) Crosswalk ( OB-2 ) | 2013-02-18 |  | Xbee Starter 200-WRL Kit |  | Trossenrobotics.com
 | 2013-02-18 |  | Digital Weight Scale |  | Amazon.com
 | 2013-02-18 |  | PIC 24 Dev Boards |  | Digi-Key.com
 | 2013-03-13 |  | Xbee 1mv Module |  | Trossenrobotics.com
 | 2013-03-19 |  | Load Sensors |  | Sparkfun.com
 | 2013-04-03 |  | PCB Board |  | Advanced Circuits.com
( L05 ) Energy Harvesters ( OB-3 ) | 2013-02-15 |  | Thermoelectric Cooler / Generator / DC to DC Boost Converter |  | Custom Thermoelectric
 | 2013-03-05 |  | Xbee Explorer Dongle / Antenna / Battery Holder / Serial LCD |  | Sparkfun.com
 | 2013-04-11 |  | One Wire Digital Temp Sensor |  | Sparkfun.com
 | 2013-04-11 |  | 3V Regs / Battery Holder |  | Digi-Key.com
 | 2013-04-12 |  | QFN to DIP SMT Adapter |  | ProtoAdvantage.com
 | 2013-04-12 |  | QFN to DIP SMT Adapters |  | ProtoAdvantage.com
( L05 ) Pyrexiar ( OB-4 ) | 2013-02-20 |  | Microcontrollers / Temp Senosrs / Bluetooth / Batteries / etc. |  | Digi-Key.com
 | 2013-04-03 |  | Temperature Sensors |  | Digi-Key.com
 | 2013-04-13 |  | BreadBoard Shield SainSmart |  | Amazon.com
Allotments: Prof. Michaels, T. 4 groups $1,552.00 Approx. max. $388.00 ea.
Group # | Date |  | Items |  | Supplier
( L02 ) Heli ( TM-1 ) | 2013-02-12 |  | MB1300 XL-MaxSonar Range Finders |  | Maxbotix.com
 | 2013-03-01 |  | IC to Parallel Cables |  | Digi-Key.com
 | 2013-03-05 |  | Logic Level Converter |  | Sparkfun.com
 | 2013-03-05 |  | Shielded Cable |  | Maxbotix.com
 | 2013-03-05 |  | SainSmart Nano v3.0 for Arduino |  | Amazon.com
(L02) KinectaBot ( TM-2 ) | 2013-03-28 |  | TVS Diodes |  | Mouser.com
( L02 ) PUMA ( TM-3 ) | 2013-03-05 |  | 2.5" x 5" x 1" Aluminum Block |  | McMasterCarr.com
 | 2013-03-13 |  | 650nm 5mw Laser Diode |  | Amazon.com
 | 2013-04-11 |  | 24"x36" cutting Pad |  | Amazon.com
( L02) RC Combat ( TM-4 ) | 2013-02-19 |  | Femtoduino Board /Shields |  | Femtoduino.com
 | 2013-03-19 |  | Femtoduino Board /Shields |  | Femtoduino.com
 | 2013-03-19 |  | Ultrasonic Transmitters and Receivers |  | Jameco.com
 | 2013-03-28 |  | Continuous Rotation Servo |  | Ebay.com
 | 2013-03-28 |  | Solar Servo D658 Mini Digital Metal Gear |  | Hobbypartz.com
 | 2013-04-02 |  | Femtoduino Board /Shields |  | Femtoduino.com
 | 2013-04-11 |  | Wasbi Batteries / Chargers for GoPro |  | Amazon.com
 | 2013-04-11 |  | GoPro Hero2 Skeleton Case |  | GoPro.com
 | 2013-04-11 |  | Green Spray Paint |  | Utrechtart.com
 | 2013-04-11 |  | Arduino Micro w/ Headers |  | Adafruit.com
Allotments: Prof. Anderson, D. 5 groups $1,940.00 Approx. max. $388.00 ea.
Group # | Date |  | Items |  | Supplier
( L03 ) BME Biotracking ( BE-1 ) | 2013-03-01 |  | Razor IMU / Bluetooth Mate Gold |  | Sparkfun.com
 | 2013-03-01 |  | Lithium Polmer USB Charger and Battery |  | Sparkfun.com
 | 2013-04-11 |  | Lithium Polmer USB Charger and Battery |  | Sparkfun.com
(L03) Audio Virtualization ( DA-1) | 2013-02-12 |  | Compass Module / Edge Connectors |  | Digi-Key.com
( L03 ) Helmet Heads ( DA-2 ) | 2013-02-19 |  | Stellaris / LM3S9D96 Dev Kits |  | Digi-Key.com
 | 2013-03-13 |  | Kit Eval LM4F120 Launch Pad |  | Digi-Key.com
 | 2013-03-21 |  | Solar Panel / Rectifier Diodes / USB Regs / Batt Holder / Battery |  | SundanceSolar.com
 | 2013-04-03 |  | TorkXPro Helmet Speakers |  | Helmetaudio.com
 | 2013-04-12 |  | IC Audio PWR Amp IC's / Caps / Resistors |  | Digi-Key.com
( L03) Low Power Speech ( DA-3 ) | 2013-04-03 |  | MSP-EXP430F55438 Board |  | Digi-Key.com
(L03) MusiCIAN (DA-4) | 2013-02-12 |  | Duracell Rechargeable Instant USB Charger |  | Amazon.com
 | 2013-02-12 |  | Graphics Display / IC I/O Expander Card |  | AdaFruit.com
 | 2013-02-12 |  | Card Edge Connector Surface Mount |  | Samtec.com
 | 2013-02-13 |  | Breakout Board for Electret Microphone |  | Sparkfun.com
 | 2013-04-12 |  | 3/8" 4-40 Pan Head Screws |  | Jameco.com
 | 2013-04-12 |  | Black Acrylic Sheetsw 12"x12" 1/8" Thick |  | McMastecarr.com
 | 2013-04-12 |  | BlueRigger 3.5mm M-M Stereo Audio Cable |  | Amazon.com
Allotments: Prof. Koblasz, A. 6 groups $2,328.00 Approx. max. $388.00 ea.
Group # | Date |  | Items |  | Supplier
( L04 ) WatchDog ( AK-1 ) | 2013-02-12 |  | Arduino Control Shield / RFID Tags |  | AdaFruit.com
 | 2013-02-12 |  | Arduino Mega / Celluar Shield / Battery Pack |  | Sparkfun.com
 | 2013-03-01 |  | Simple RF Reciever / Remote Control / Headers |  | AdaFruit.com
 | 2013-04-11 |  | WiFi Adapter |  | Amazon.com
 | 2013-04-11 |  | USB Battery Packs |  | Monoprice.com
 | 2013-04-12 |  | Quad-Band Cellular Antennas |  | Sparkfun.com
(L04) Medication Tray ( AK-2)
( L04 ) Buzzister ( AK-3 )
( L04) Augmented Comm ( AK-4 ) | 2013-02-04 |  | 9 Dergrees of freedom Sensor Stick |  | Sparkfun.com
 | 2013-03-05 |  | NFC Module for Arduino |  | Adafruit.com
 | 2013-03-26 |  | Headers / Breakout Boards / LED's / Arduino / FTDI Cable |  | Sparkfun.com
 | 2013-03-26 |  | USB Optical Mouse |  | Amazon.com
 | 2013-03-26 |  | Bite Switch 2.5mm Plug |  | ChutingStar.com
 | 2013-03-28 |  | Ear Mounting Device |  | Earhoox.com
 | 2013-03-26 |  | Audio Jack Connectors |  | Digi-Key.com
 | 2013-04-11 |  | Super Mini Bluetooth Dongle / Arduino Bluetooth Wireless Port |  | DX.com
 | 2013-04-11 |  | Arduino Pro/Headers/Battery/Charger/9 Degrees of Freedom |  | Sparkfun.com
 | 2013-04-16 |  | Arduino Pro Mini |  | Sparkfun.com
(L04) Smart Locks (AK-5) | 2013-03-01 |  | Single Cylinder Deadbolt |  | PullsDirect.com
 | 2013-03-01 |  | Wireless Surveillance Camera |  | Amazon.com
 | 2013-03-01 |  | Reed Relay / Battery |  | Digi-Key.com
(L04) RFID Pacemaker (MW-5) | 2013-04-02 |  | Variable Capacitor Antenna Tunner |  | RFParts.com
 | 2013-04-02 |  | 134.2 KHz Antenna |  | Mouser.com
Allotments: Prof. Ingram, M. 6 groups $2,328.00 Approx. max. $388.00 ea.
Group # | Date |  | Items |  | Supplier
( L04 ) Wireless Speakers ( MW-1 ) | 2013-02-04 |  | Raspberry Pi Dev Boards |  | MCM Electronics
 | 2013-02-04 |  | SD Card Flash 4GB |  | NewEgg.com
 | 2012-02-04 |  | USB Blue Tooth Adapters and Wireless Adapters |  | Amazon.com
 | 2013-02-04 |  | USB Power Port Adpater |  | Digi-Key.com
 | 2013-02-11 |  | Flush Mount / Tappered Headed Cushion Cutters |  | All-Spec.com
 | 2013-02-12 |  | USB to USB Micro |  | Amazon.com
 | 2013-02-12 |  | RF Link Transmitter and Receivers |  | Sparkfun.com
 | 2013-03-01 |  | Wireless Adapter Wizard |  | Amazon.com
(L04)SoundTrack ( MW-2) | 2013-02-19 |  | Xbee Wi-Fi Wire Antenna / Development Kit |  | Mouser.com
 | 2013-03-06 |  | ConnRecptUltra-MiniCoax/CableAssemUFL-UFL/Module 802.15.4 |  | Digi-Key.com
 | 2013-03-28 |  | Xbee Wi-Fi Antenna / Digital Pots |  | Digi-Key.com
 | 2013-04-10 |  | Digital Pots 10K Ohm |  | Mouser.com
 | 2013-04-16 |  | Audio D/A Converter |  | Mouser.com
( L04 ) RoboBear ( MW-3 ) | 2013-02-04 |  | EasyVR Voice Recognition Shield |  | Sparkfun.com
 | 2013-02-18 |  | Bluetooth Low Energy Arduino Shield |  | Makershield.com
 | 2013-02-20 |  | Arduino Microcontroller |  | Amazon.com
 | 2013-03-13 |  | Arduino Uno R3 / PlexiGlass Sheet |  | Amazon.com
 | 2013-03-28 |  | Maximal Power 9V Battery Charger |  | Amazon.com
 | 2013-04-11 |  | Maximal Power 9V Battery Charger |  | Amazon.com
 | 2013-04-11 |  | 1/4" Clear Acrylic Plexiglass |  | Amazon.com
( L04) RF Harvesting ( MW-4 ) | 2013-03-19 |  | PowerCast Transmitter |  | Mouser.com
(L04) ECM (MW-6) | 2013-02-12 |  | Resistors / Caps / Votage Regs / Trimmer Pots / Etc. |  | Digi-Key.com
 | 2013-02-12 |  | VCO / DBL Bal / Broadband Amps / FXD SS Atten / etc. |  | Mini-Circuits.com
 | 2013-02-12 |  | SMD Caps/ Resistors / LEDs |  | Mouser.com
 | 2013-02-12 |  | Function Generator Chips |  | Tayda.com
 | 2013-04-12 |  | SMA Bulkhead Connection Solder Cup |  | Mouser.com
 | 2013-04-12 |  | SMA-SMA M-M 6" Cables |  | Mini-Circuits.com
 | 2013-04-12 |  | SMA Connection Cable w/ Female Plug |  | DX.com
(L04) Neuro Sphere (MW-7) | 2013-02-04 |  | Arduino Bluetooth Adapter / Arduino Mega 2560 |  | Sparkfun.com
 | 2013-02-04 |  | Sphero Ball |  | Amazon.com
 | 2013-02-20 |  | Bluetooth Donlge |  | Amazon.com
 | 2013-03-01 |  | Multipurpose Contact Solution |  | Amazon.com
Allotments: Prof. Hunt, B. 5 groups $1,940.00 Approx. max. $388.00 ea.
Group # | Date |  | Items |  | Supplier
( L05 ) Accel Music ( BH-1 ) | 2013-02-05 |  | ADXL-345 Accelerometer |  | Sparkfun.com
 | 2013-02-05 |  | Large Cycling Gloves |  | Amazon.com
 | 2013-03-13 |  | 4GB SD Card w/ Adapter |  | Amazon.com
 | 2013-04-03 |  | 4 GB Micro Bluetooth Audio Transmitter / Wireless Speakers |  | Digi-Key.com
 | 2013-04-11 |  | Plastic Box |  | Digi-Key.com
 | 2013-04-12 |  | M to F 180 Degree 5 Pin Cable |  | Cablesdirect.com
(L05) Psycho Acoustics ( BH-2) | 2013-02-12 |  | Sensor GridEye / 3.3 Voltage Regs / Digital Pots |  | Digi-Key.com
 | 2013-02-12 |  | Pyle 360 Watt 3 Way Speakers |  | Amazon.com
 | 2013-03-13 |  | Digital Pots 50K |  | Digi-Key.com
( L05 ) Safe Helmet ( BH-3 ) | 2013-02-15 |  | LilyPAd Arduino / Bluetooth Breakout / Bluetooth Mate Gold |  | Sparkfun.com
 | 2013-02-15 |  | ADXL-377 Breakout Board |  | Digi-Key.com
 | 2013-02-15 |  | Pulse Sensors |  | Adafruit.com
 | 2013-02-15 |  | Motorcycle Helmet |  | Amazon.com
 | 2013-02-15 |  | Breakout Boards / Arduino LilyPad / BlueGiga WT-32 |  | Sparkfun.com
 | 2013-02-15 |  | Piezoelectric Film |  | Imagesco.com
 | 2013-02-15 |  | Pulse Senors |  | Adafruit.com
 | 2013-02-15 |  | ADXL-345 Accelerometer Breakout Boards |  | Digi-Key.com
 | 2013-03-05 |  | HackHD without PCB and 5.5mm F2.5 Pin Hole Lens |  | Hackhd.com
 | 2013-03-21 |  | MicroSD Extension Cable |  | Amazon.com
 | 2013-04-16 |  | Multiplexers / Enclosures |  | Mouser.com
 | 2013-04-16 |  | Multiplexers / Enclosures |  | Mouser.com
( L05) Smart Faucet ( BH-4 ) | 2013-02-18 |  | Mechanical Mixing Valve |  | Amazon.com
 | 2013-03-01 |  | IR Proximity Sensor |  | Sparkfun.com
 | 2013-03-01 |  | Nylon Gears |  | McMasterCarr.com
 | 2013-04-03 |  | Plexiglass Sheets Infrared Transmitting |  | Eplastics.com
(L05) Stompbox (BH-5) | 2013-02-04 |  | SliceKit Starter Kit |  | Digi-Key.com
 | 2013-03-01 |  | SliceKit Audio Slice Card |  | Digi-Key.com
 | 2013-03-01 |  | LED's Uni Color |  | Jameco.com
 | 2013-03-01 |  | Black Enclosure |  | Mouser.com
 | 2013-03-01 |  | 3 PDT Stomp Switch |  | Stewmac.com
 | 2013-03-26 |  | PCI Extension Cable / USB M-M and F-F Extension Cables |  | Ebay.com
 | 2013-03-26 |  | 1/4" TRS Cable / 3.5 mm Plugs and Jacks |  | Monoprice.com
 | 2013-03-26 |  | 1/4" TRS Jack |  | Speakerrepair.com
 | 2013-04-11 |  | USB Audio 2.0 Board |  | Digi-Key.com
Group # | Date | Amount |  | Total | Items
Senior Design | 2013-01-30 |  | Powercast Energy Harvesting Dev Kit for Wireless Sensors |  | Microchip Direct
Senior Design | 2012-02-04 |  | Arduino Duo Dev Board |  | Digi-Key.com
Senior Design | 2013-02-12 |  | Various USB Cables |  | ShowMeCable.com
Senior Design | 2013-02-27 |  | Adhesive-Back Bumpers |  | McMasterCarr.com
Senior Design | 2013-04-08 |  | Basic 16x2 Character LCD's |  | Sparkfun.com
Senior Design | 2013-04-16 |  | 40 1-pin-1pin Jumper Lines |  | Amazon.com
Senior Design | 2013-04-18 |  | Arduino Mega ADK R3 / Beginning Andriod ADK Book |  | Amazon.com
Senior Design
Senior Design
Senior Design
Senior Design
Senior Design
Senior Design
Senior Design
