Furkannn/senior-design/Solidworks/Ear Mount Design/Version 5/FullModel.SLDASM

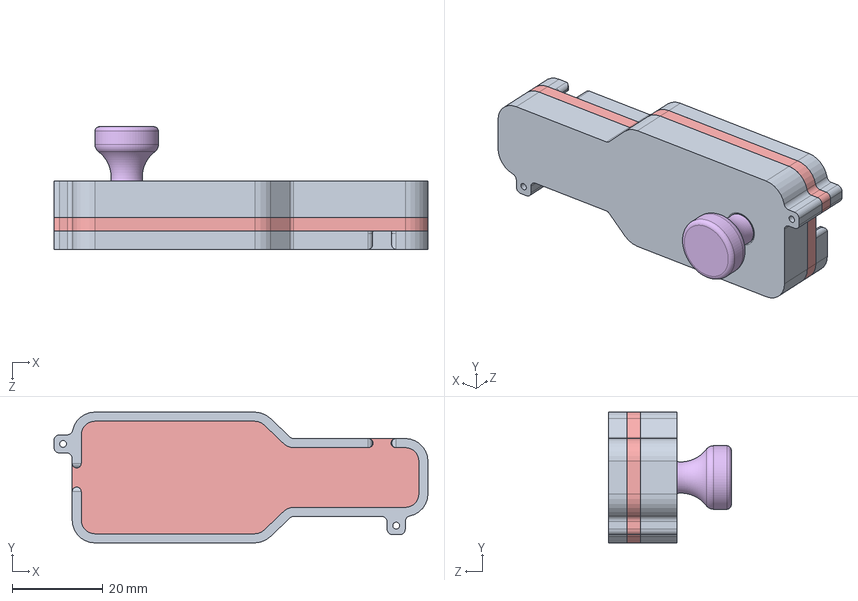
[picture p61: CAD file, 2013-04-03]
Solidworks/Ear Mount Design/Version 5/FullModel.SLDASM
82.3 x 28.8 x 27.0 mm
CaseBottom
PCB
IMU
Arduino
CaseCover
EarPlug
