Furkannn/senior-design/Solidworks/Electronics Box/EBoxAssembly_final.SLDASM

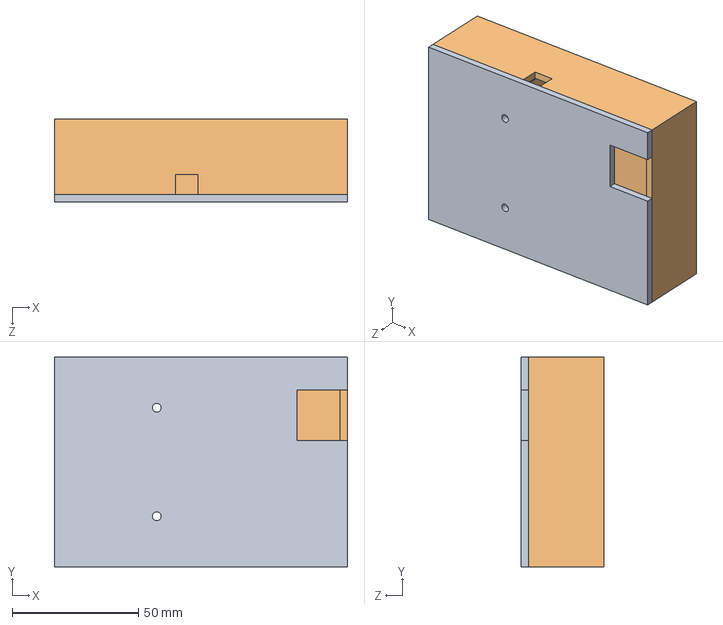
[picture p62: CAD file, 2013-04-25]
Solidworks/Electronics Box/EBoxAssembly_final.SLDASM
116.0 x 83.0 x 33.0 mm
BoxCover_final
OuterBox_final
