Furkannn/senior-design/Solidworks/Electronics Box/EBoxAssembly.SLDASM

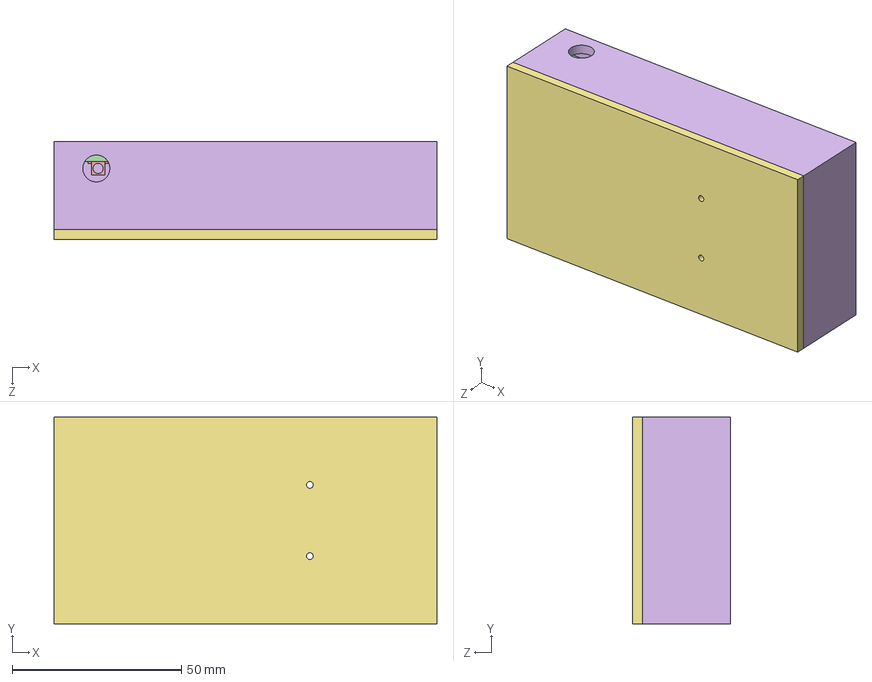
[picture p63: CAD file, 2013-04-09]
Solidworks/Electronics Box/EBoxAssembly.SLDASM
113.0 x 61.0 x 29.0 mm
Arduino
battery
BluetoothTransmitter
PCB
audioJack
OuterBox
BoxCover
