Furkannn/senior-design/Solidworks/box2/BoxCover.STL

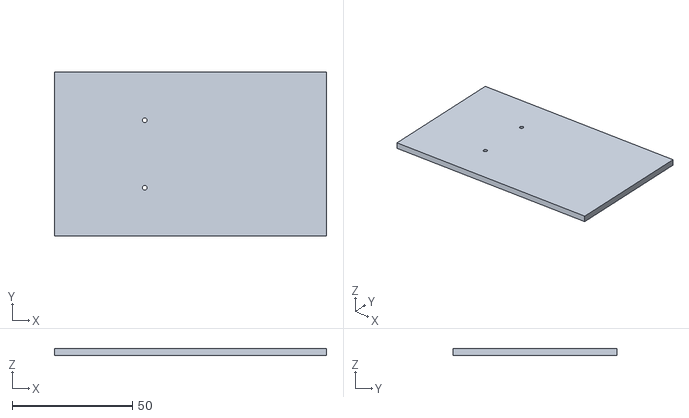
[picture p64: CAD file, 2013-04-25]
Solidworks/box2/BoxCover.STL
113.0 x 68.0 x 3.00
