Furkannn/senior-design/Solidworks/Ear Mount Design/Headphone Example.SLDPRT

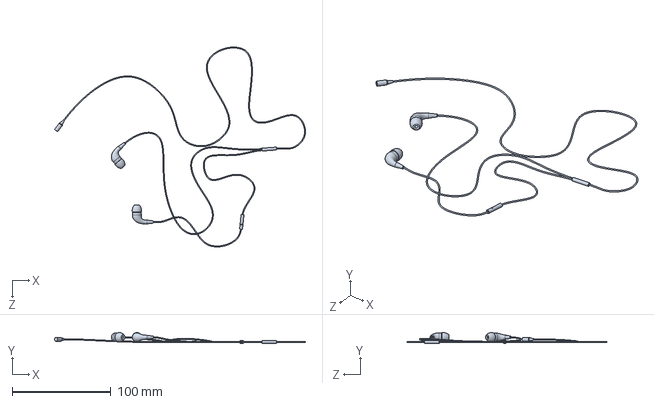
[picture p65: CAD file, 2013-03-26]
Solidworks/Ear Mount Design/Headphone Example.SLDPRT
253.6 x 11.1 x 202.0 mm
