Furkannn/senior-design/Solidworks/Ear Mount Design/Version 5/EarPlug.SLDPRT

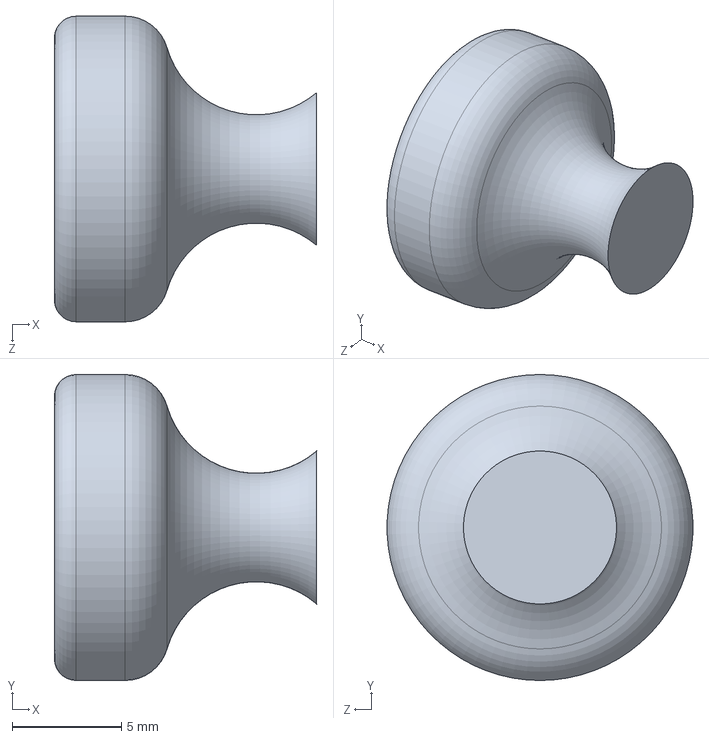
[picture p66: CAD file, 2013-04-06]
Solidworks/Ear Mount Design/Version 5/EarPlug.SLDPRT
12.0 x 14.0 x 14.0 mm
