Furkannn/senior-design/Solidworks/Electronics Box/BoxCover_final.SLDPRT

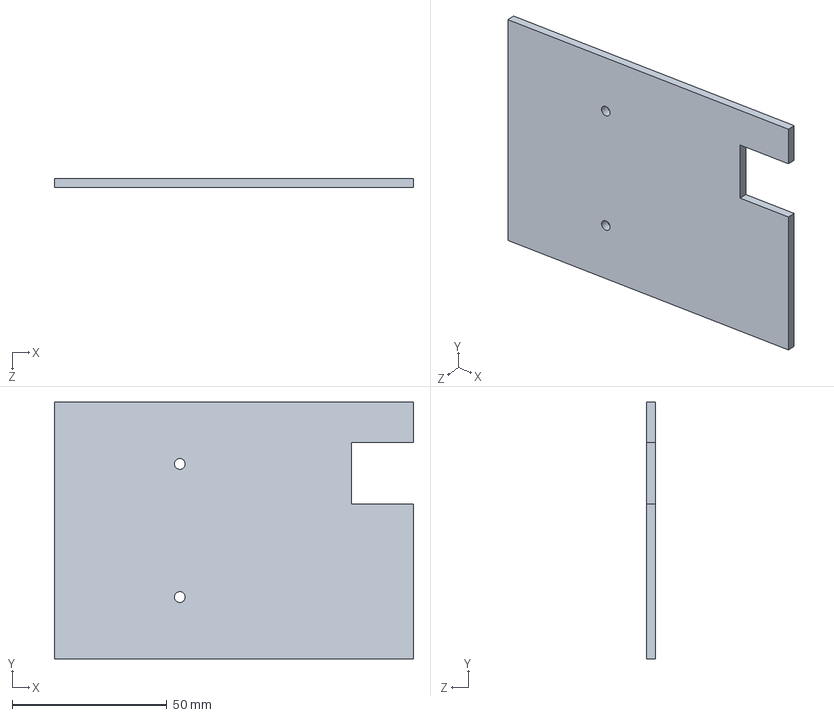
[picture p67: CAD file, 2013-04-25]
Solidworks/Electronics Box/BoxCover_final.SLDPRT
116.0 x 83.0 x 3.00 mm
