Furkannn/senior-design/Solidworks/Photosensor/Part1.SLDPRT

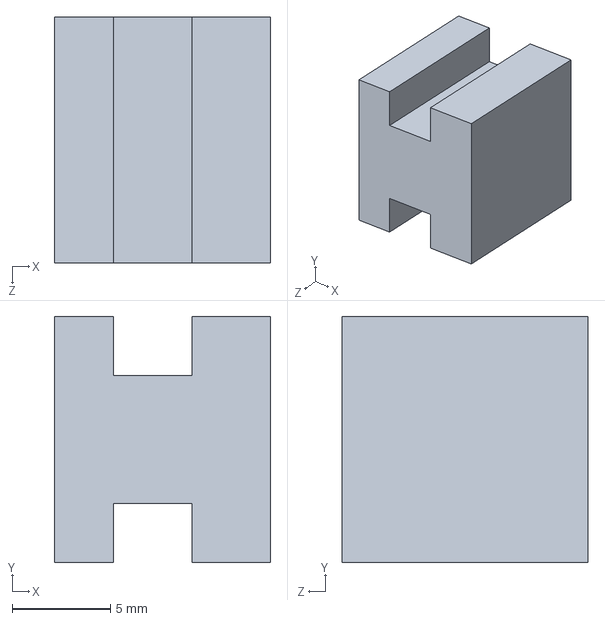
[picture p68: CAD file, 2013-04-01]
Solidworks/Photosensor/Part1.SLDPRT
11.0 x 12.5 x 12.5 mm
