Furkannn/senior-design/Solidworks/box2/OuterBox.STL

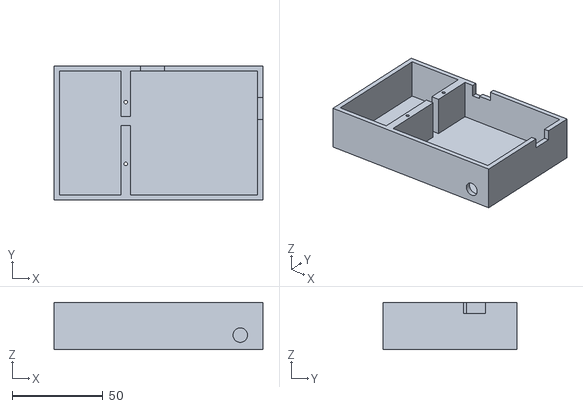
[picture p69: CAD file, 2013-04-25]
Solidworks/box2/OuterBox.STL
115.0 x 74.0 x 26.0
