Furkannn/senior-design/Solidworks/Electronics Box/OuterBox_final.SLDPRT

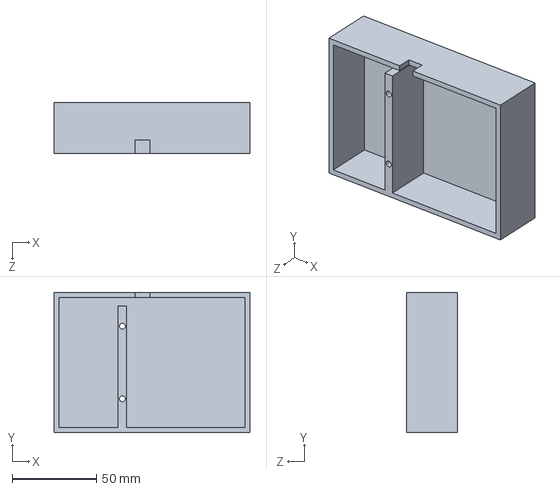
[picture p70: CAD file, 2013-04-25]
Solidworks/Electronics Box/OuterBox_final.SLDPRT
116.0 x 83.0 x 30.0 mm
