Furkannn/senior-design/Solidworks/Photosensor/Part1_fixed.SLDPRT

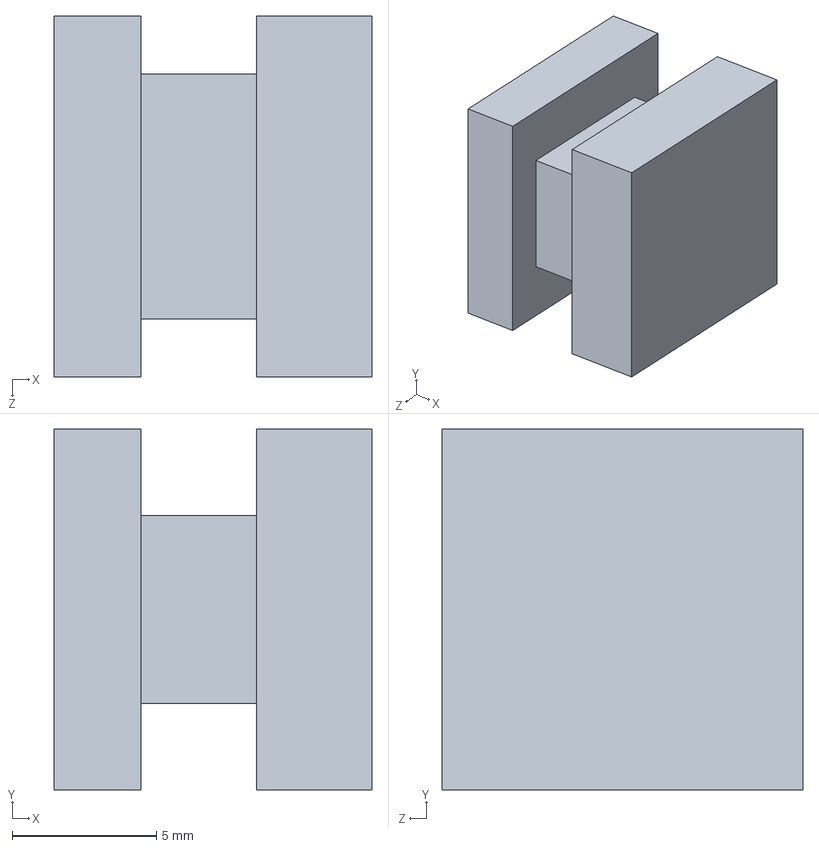
[picture p71: CAD file, 2013-04-01]
Solidworks/Photosensor/Part1_fixed.SLDPRT
11.0 x 12.5 x 12.5 mm
