Furkannn/senior-design/Solidworks/Ear Mount Design/Version 5/CaseCover.SLDPRT

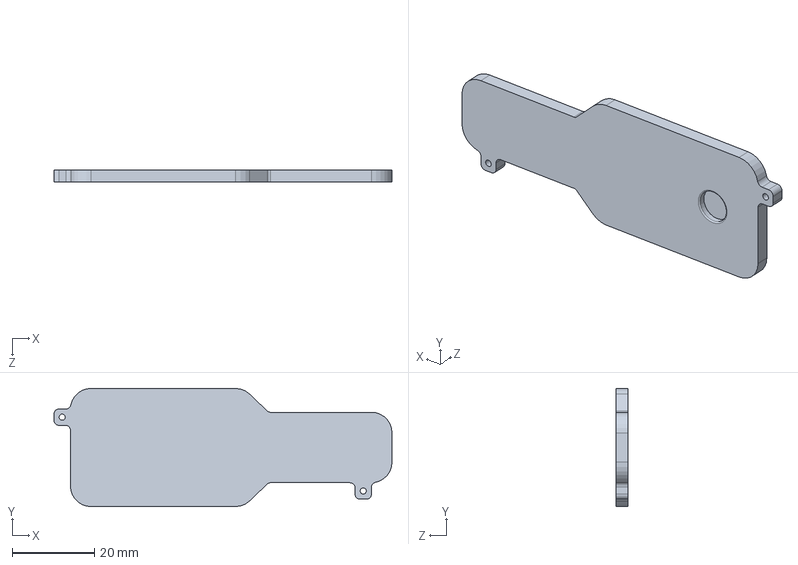
[picture p72: CAD file, 2013-04-03]
Solidworks/Ear Mount Design/Version 5/CaseCover.SLDPRT
82.3 x 28.8 x 3.00 mm
