Furkannn/senior-design/Solidworks/OFSMount_v5.SLDPRT

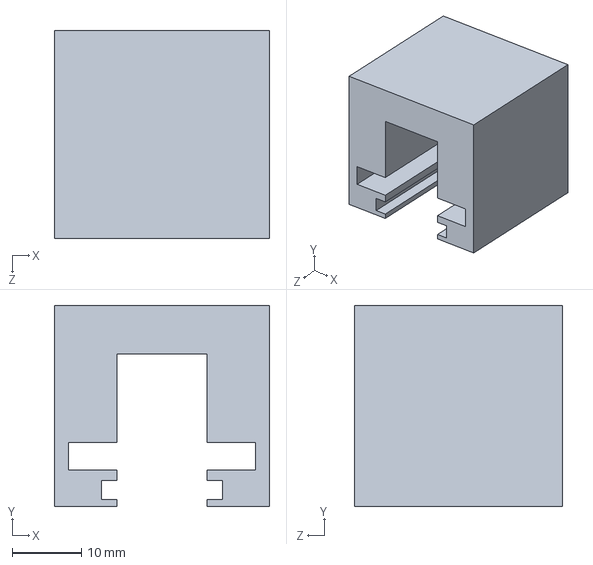
[picture p73: CAD file, 2013-03-24]
Solidworks/OFSMount_v5.SLDPRT
31.0 x 29.0 x 30.0 mm
