Furkannn/senior-design/Solidworks/Ear Mount Design/Version 5/CaseBottom.SLDPRT

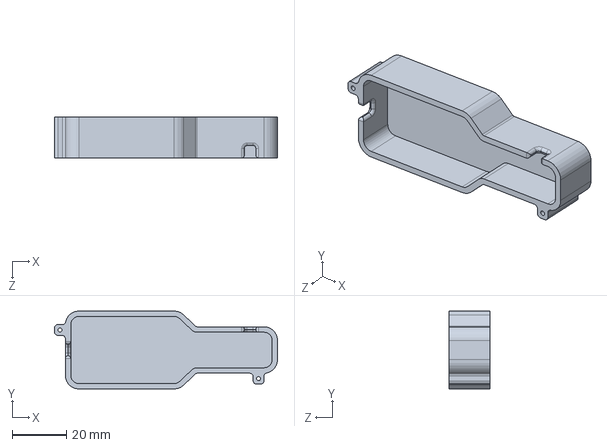
[picture p74: CAD file, 2013-04-03]
Solidworks/Ear Mount Design/Version 5/CaseBottom.SLDPRT
82.3 x 28.8 x 15.0 mm
