Furkannn/senior-design/Solidworks/Ear Mount Design/Version 5/Arduino.SLDPRT

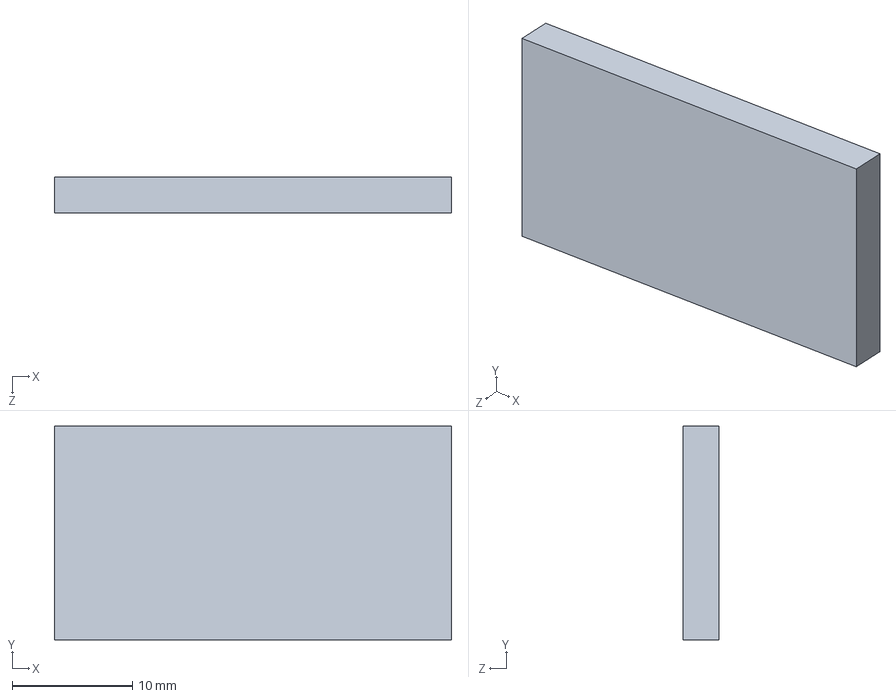
[picture p75: CAD file, 2013-03-26]
Solidworks/Ear Mount Design/Version 5/Arduino.SLDPRT
33.0 x 17.8 x 3.00 mm
