Furkannn/senior-design/Solidworks/Electronics Box/BoxCover.SLDPRT

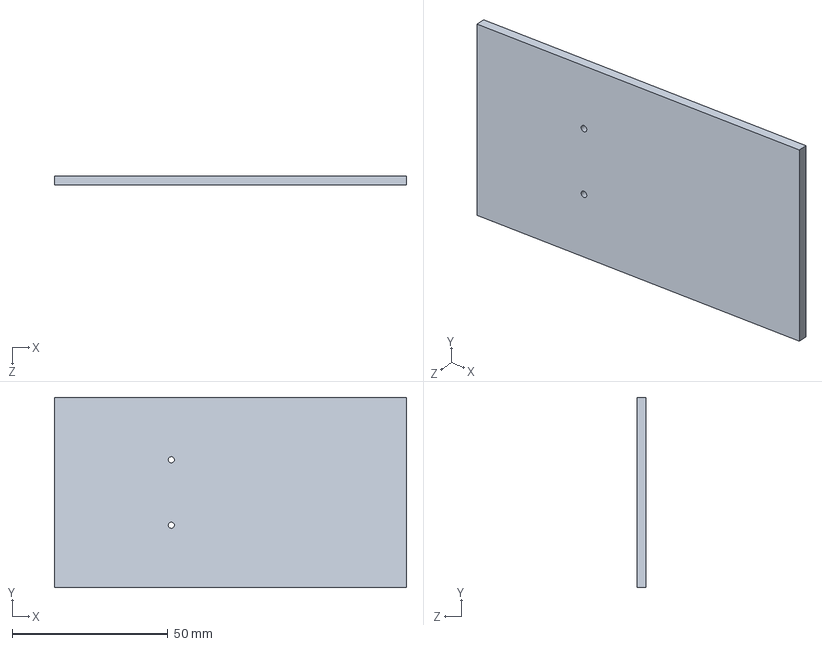
[picture p76: CAD file, 2013-04-09]
Solidworks/Electronics Box/BoxCover.SLDPRT
113.0 x 61.0 x 3.00 mm
