Furkannn/senior-design/Solidworks/Part1.SLDPRT

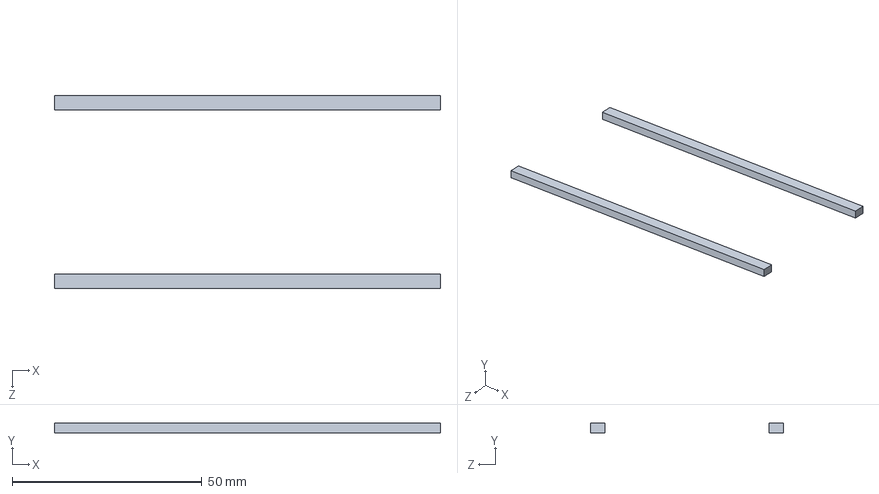
[picture p77: CAD file, 2013-03-24]
Solidworks/Part1.SLDPRT
101.6 x 2.54 x 50.8 mm
