Furkannn/senior-design/Solidworks/Ear Mount Design/Version 5/IMU.SLDPRT

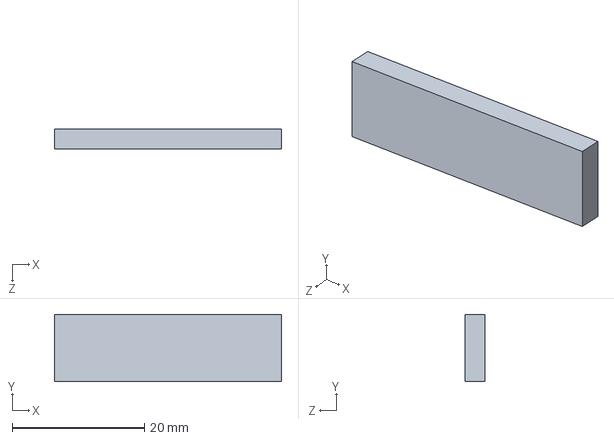
[picture p78: CAD file, 2013-03-26]
Solidworks/Ear Mount Design/Version 5/IMU.SLDPRT
34.3 x 10.2 x 3.00 mm
