Furkannn/senior-design/Solidworks/Electronics Box/battery.SLDPRT

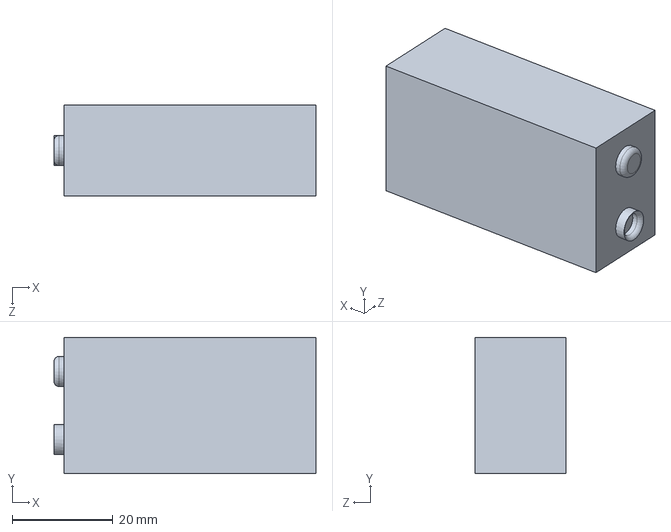
[picture p79: CAD file, 2013-04-09]
Solidworks/Electronics Box/battery.SLDPRT
52.0 x 27.0 x 18.0 mm
