Furkannn/senior-design/Solidworks/Ear Mount Design/Version 5/PCB.SLDPRT

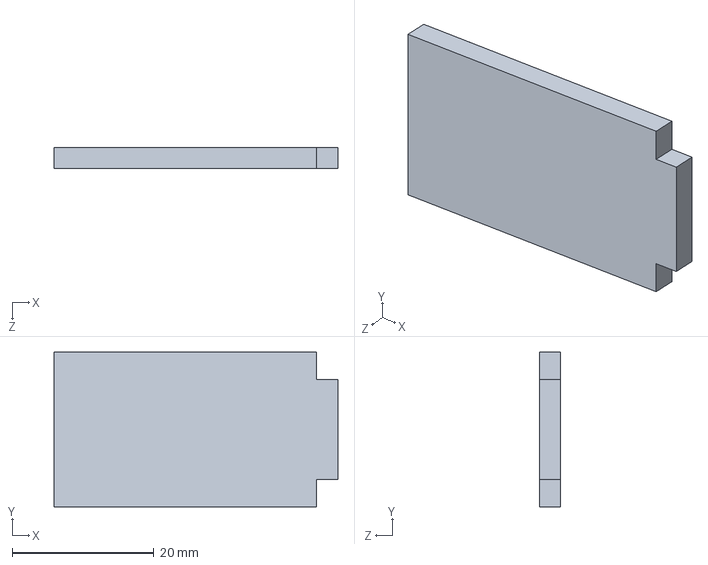
[picture p80: CAD file, 2013-03-26]
Solidworks/Ear Mount Design/Version 5/PCB.SLDPRT
40.0 x 21.8 x 3.00 mm
