Furkannn/senior-design/Solidworks/Electronics Box/PCB.SLDPRT

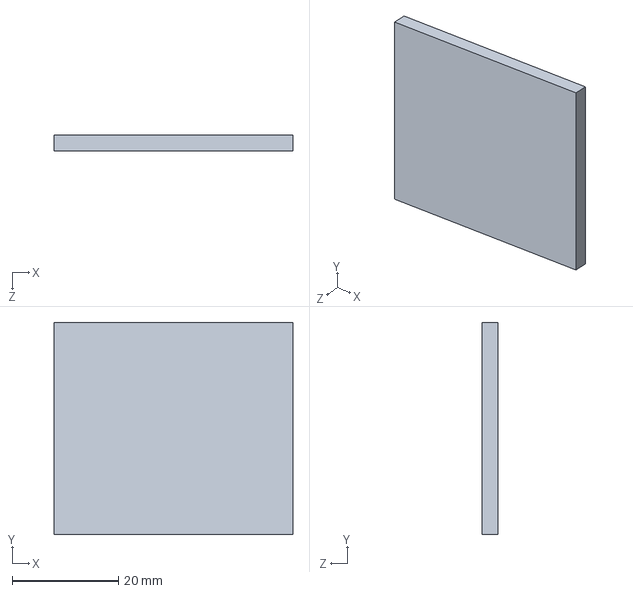
[picture p81: CAD file, 2013-04-09]
Solidworks/Electronics Box/PCB.SLDPRT
45.0 x 40.0 x 3.00 mm
