Furkannn/senior-design/Solidworks/Electronics Box/BluetoothTransmitter.SLDPRT

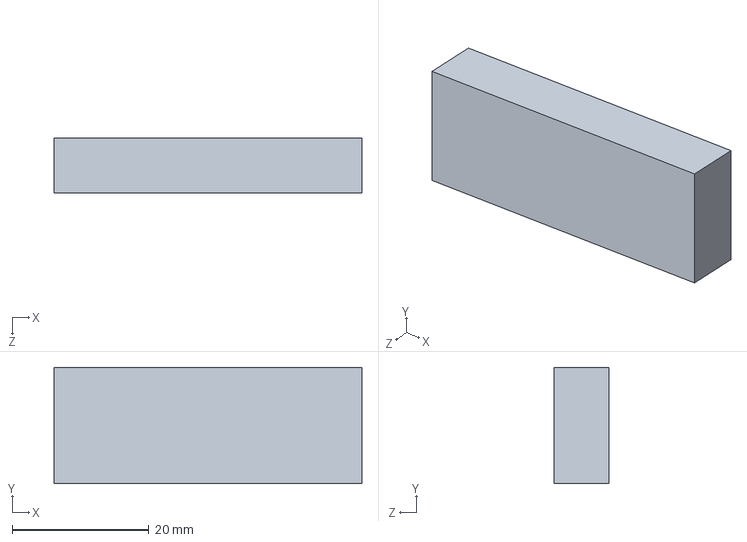
[picture p82: CAD file, 2013-04-06]
Solidworks/Electronics Box/BluetoothTransmitter.SLDPRT
45.0 x 17.0 x 8.00 mm
