Furkannn/senior-design/Solidworks/Electronics Box/audioJack.SLDPRT

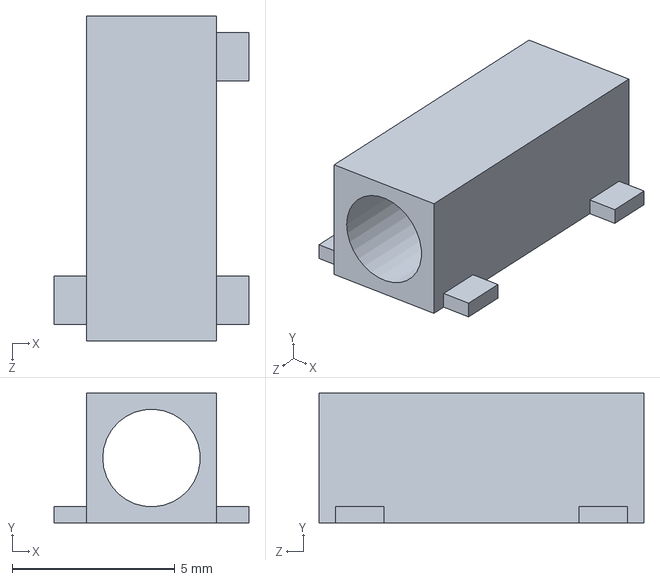
[picture p83: CAD file, 2013-04-06]
Solidworks/Electronics Box/audioJack.SLDPRT
6.00 x 4.00 x 10.0 mm
