Furkannn/senior-design/Solidworks/Electronics Box/Arduino.SLDPRT

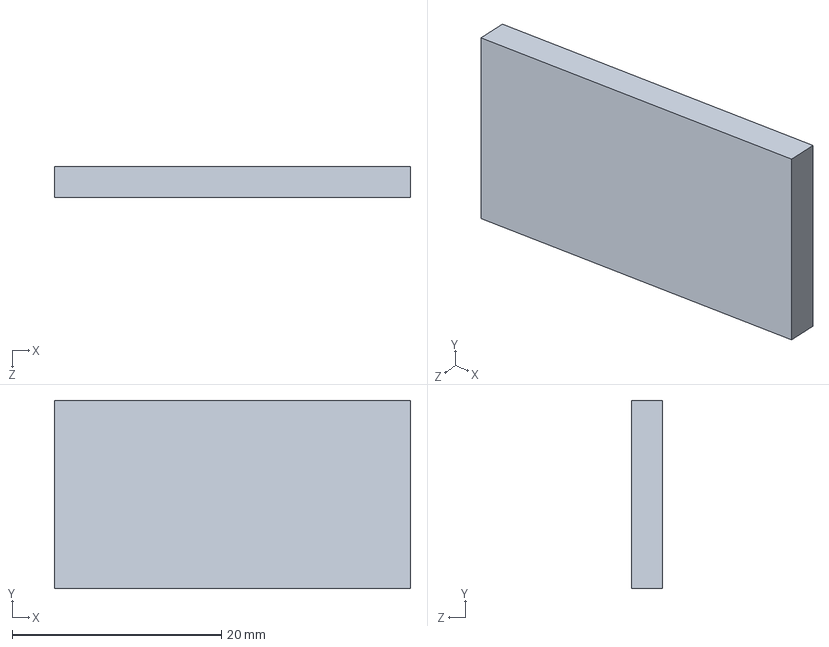
[picture p84: CAD file, 2013-04-06]
Solidworks/Electronics Box/Arduino.SLDPRT
34.0 x 18.0 x 3.00 mm
