Furkannn/senior-design/(list of files, cad)

Other CAD files:
Solidworks/Ear Mount Design/Version 1/ArduinoProMini.SLDPRT
Solidworks/Ear Mount Design/Version 1/CaseModel.SLDPRT
Solidworks/Ear Mount Design/Version 1/EarPlug.SLDPRT
Solidworks/Ear Mount Design/Version 1/IMU.SLDPRT
Solidworks/Ear Mount Design/Version 1/OverAllModel.SLDASM
Solidworks/Ear Mount Design/Version 1/PCB.SLDPRT
Solidworks/Ear Mount Design/Version 2/CaseBottom.SLDPRT
Solidworks/Ear Mount Design/Version 2/CaseCover.SLDPRT
Solidworks/Ear Mount Design/Version 2/EarPlug.SLDPRT
Solidworks/Ear Mount Design/Version 2/FullModel.SLDASM
Solidworks/Ear Mount Design/Version 3/CaseBottom.SLDPRT
Solidworks/Ear Mount Design/Version 3/CaseBottom.STL
Solidworks/Ear Mount Design/Version 3/CaseCover.SLDPRT
Solidworks/Ear Mount Design/Version 3/EarPlug.SLDPRT
Solidworks/Ear Mount Design/Version 3/FullModel.SLDASM
Solidworks/Ear Mount Design/Version 4/CaseBottom.STL
Solidworks/Ear Mount Design/Version 4/CaseCover.STL
Solidworks/Ear Mount Design/Version 4/EarPlug.SLDPRT
Solidworks/Ear Mount Design/Version 5/CaseBottom.STL
Solidworks/Ear Mount Design/Version 5/CaseCover.STL
Solidworks/Electronics Box/BoxCover_final.STL
Solidworks/Electronics Box/OuterBox_final.STL
Solidworks/OFSMount_v1.SLDPRT
Solidworks/OFSMount_v1.STL
Solidworks/OFSMount_v4.SLDPRT
Solidworks/OFSMount_v4.STL
Solidworks/OFSMount_v5.STL
Solidworks/OFSmount_v2.SLDPRT
Solidworks/OFSmount_v2.STL
Solidworks/Photosensor/Part1.STL
Solidworks/Photosensor/Part1_fixed.STL
solidworks/OFSMount_v1.SLDPRT
solidworks/OFSMount_v1.STL
solidworks/OFSMount_v4.SLDPRT
solidworks/OFSMount_v4.STL
solidworks/OFSMount_v5.STL
solidworks/OFSmount_v2.SLDPRT
solidworks/OFSmount_v2.STL
