Furkannn/senior-design/Solidworks/Electronics Box/EBoxAssembly.JPG

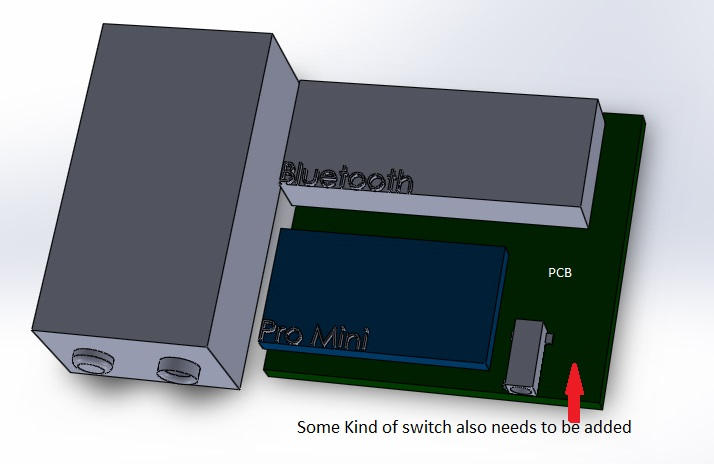
Solidworks/Electronics Box/EBoxAssembly.JPG
