Furkannn/senior-design/2. Proposal/Pictures/testgantt.JPG

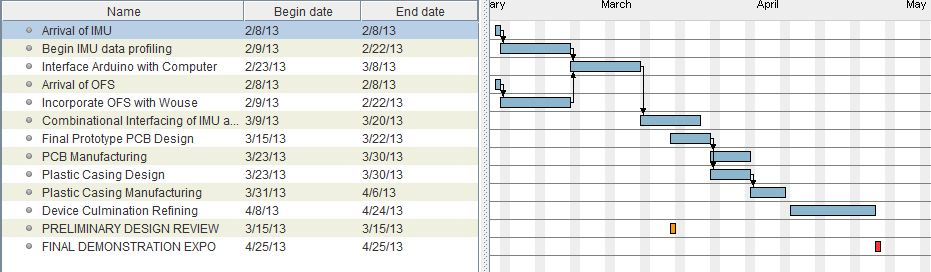
2. Proposal/Pictures/testgantt.JPG
