Furkannn/senior-design/PCB Design/Box PCB/box''.pdf

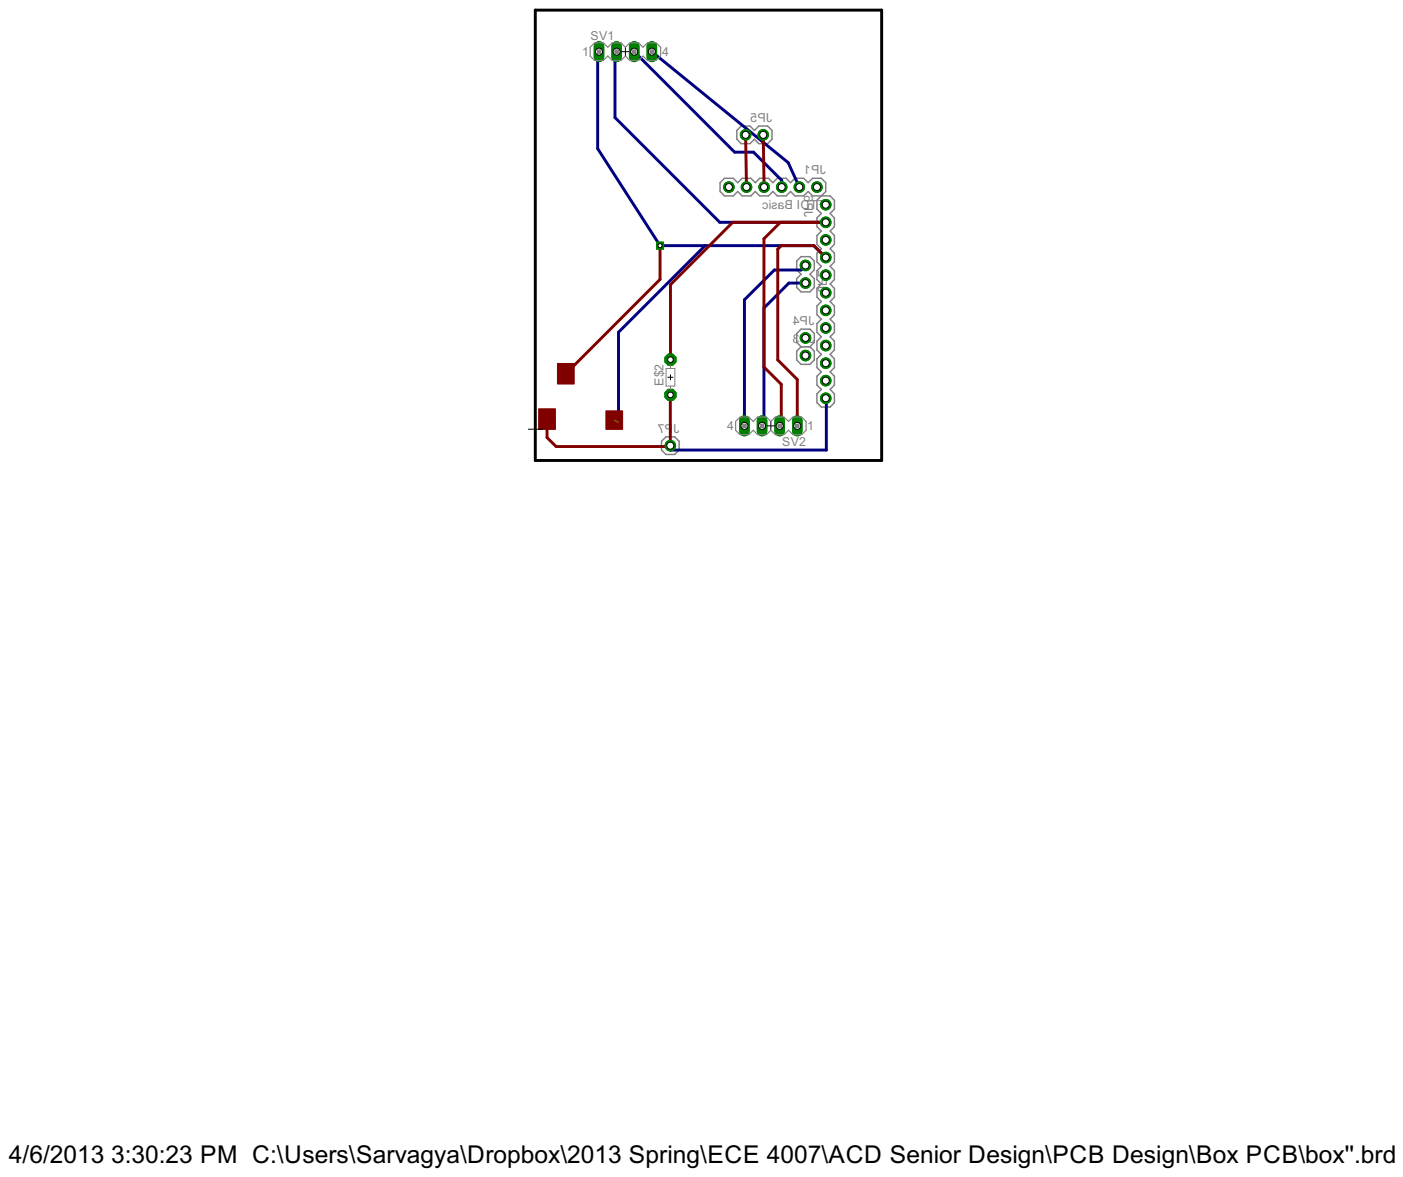
[picture p87: page 1]

4/6/2013 3:30:23 PM C:\Users\Sarvagya\Dropbox\2013 Spring\ECE 4007\ACD Senior Design\PCB Design\Box PCB\box''.brd
