Furkannn/senior-design/Solidworks/mm-graph-paper.pdf

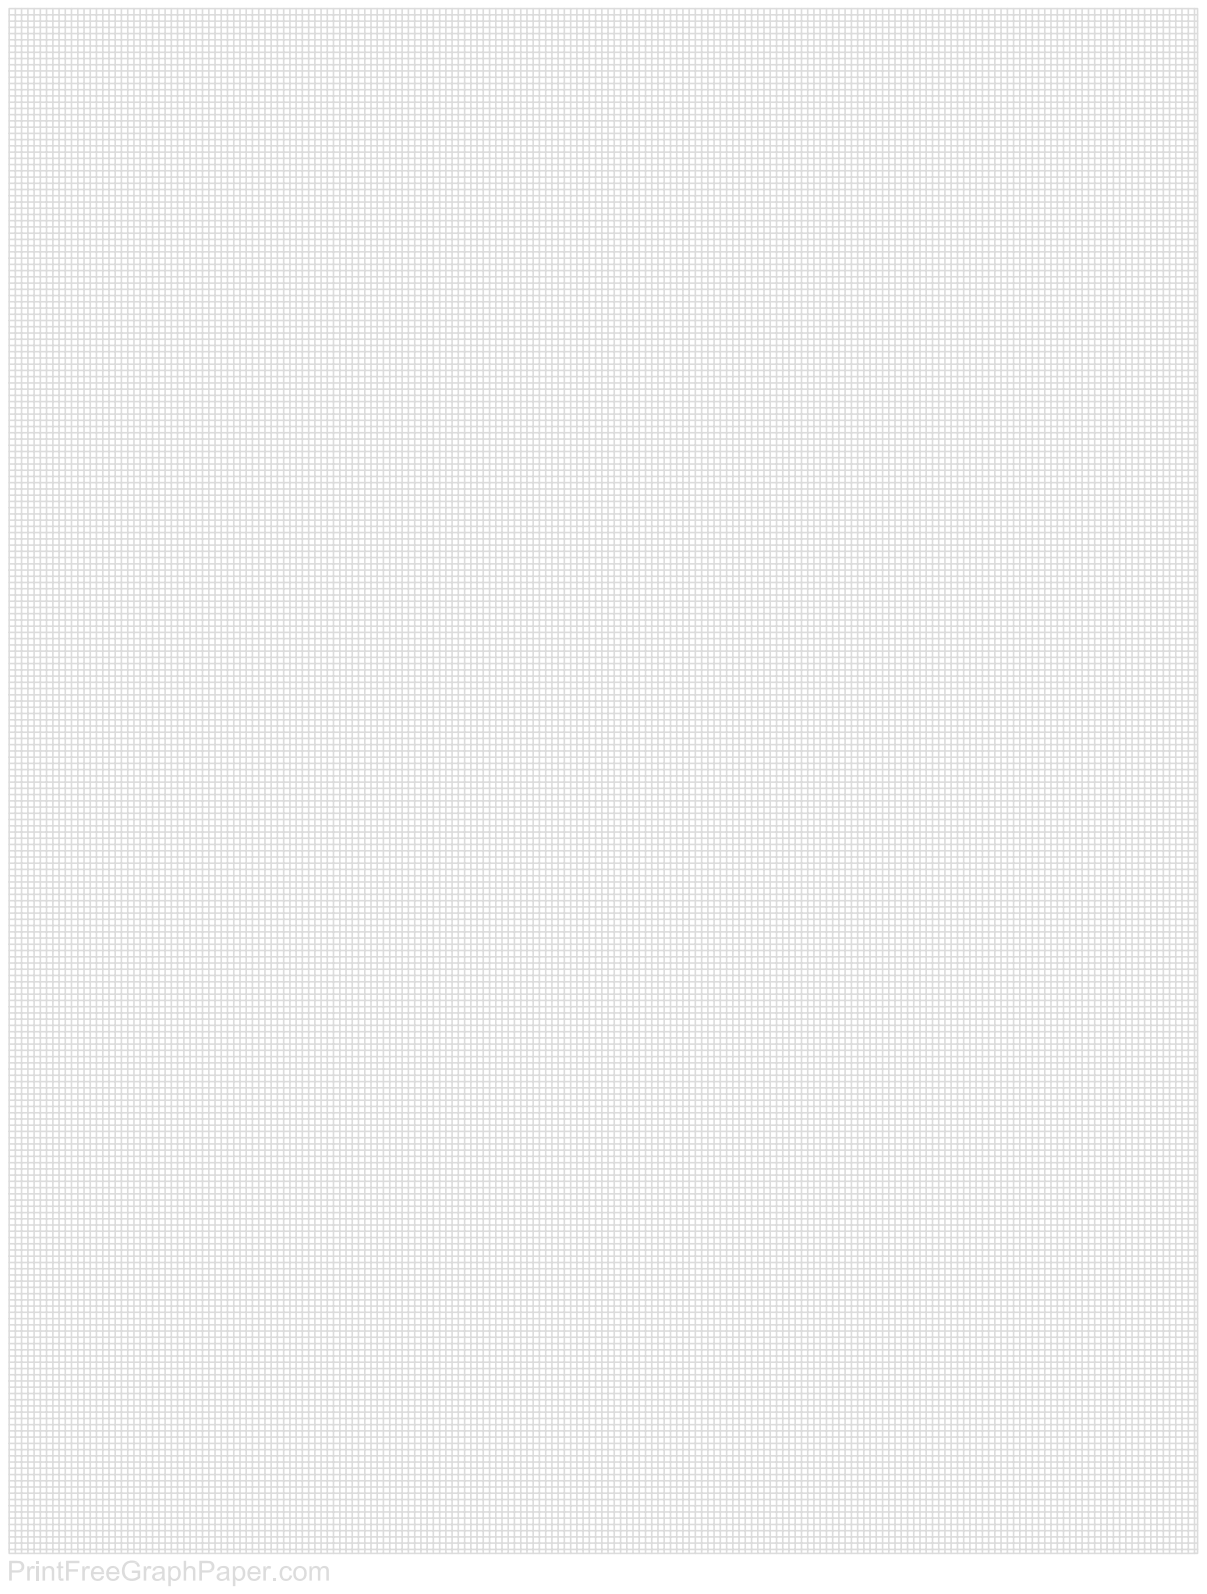
[picture p88: page 1]
