Furkannn/senior-design/PCB Design/Box PCB/box'.brd

## EAGLE design PCB Design/Box PCB/box'.brd (2013-04-09)

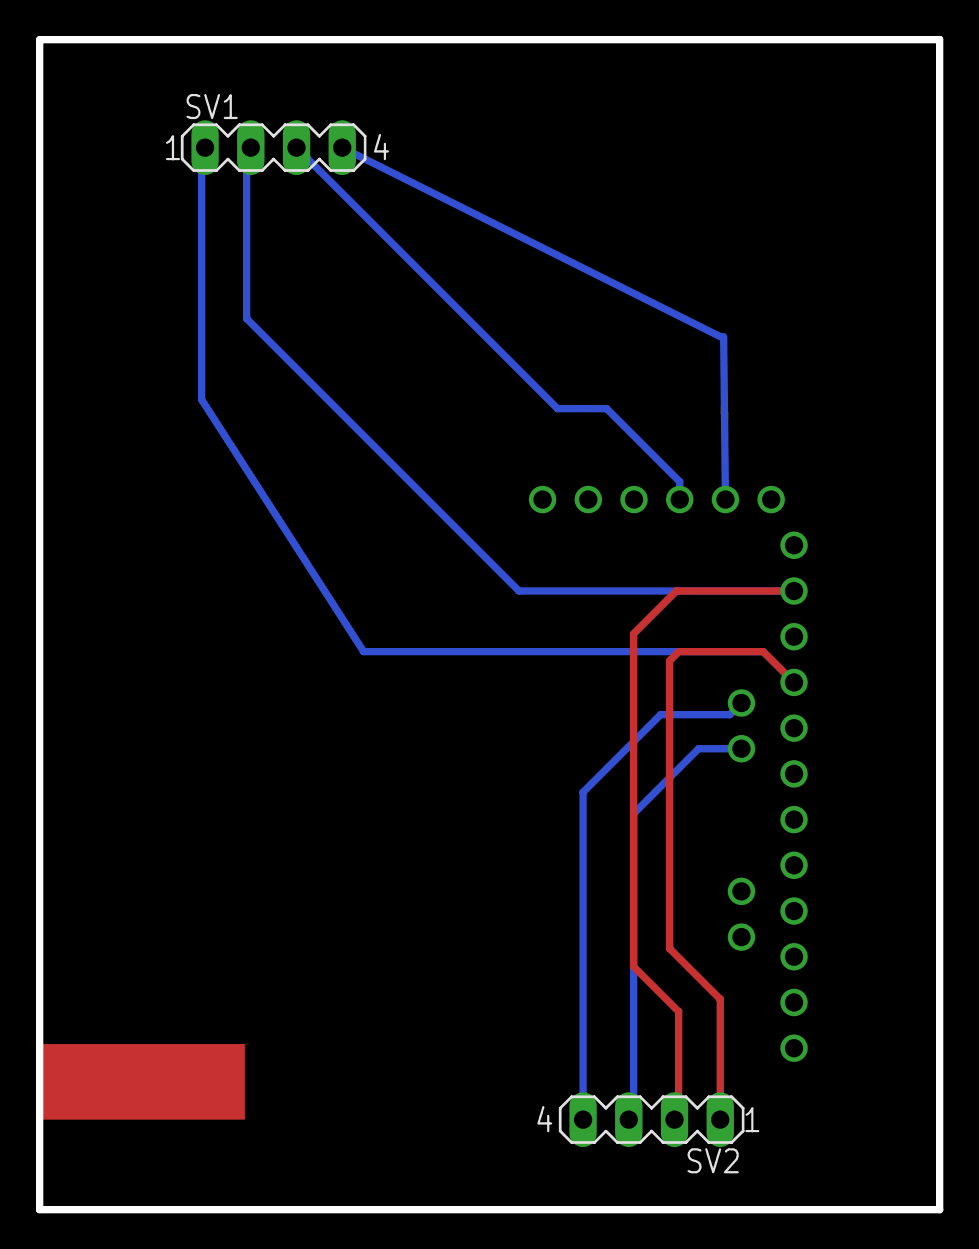
[picture p89: board box'.brd from above]

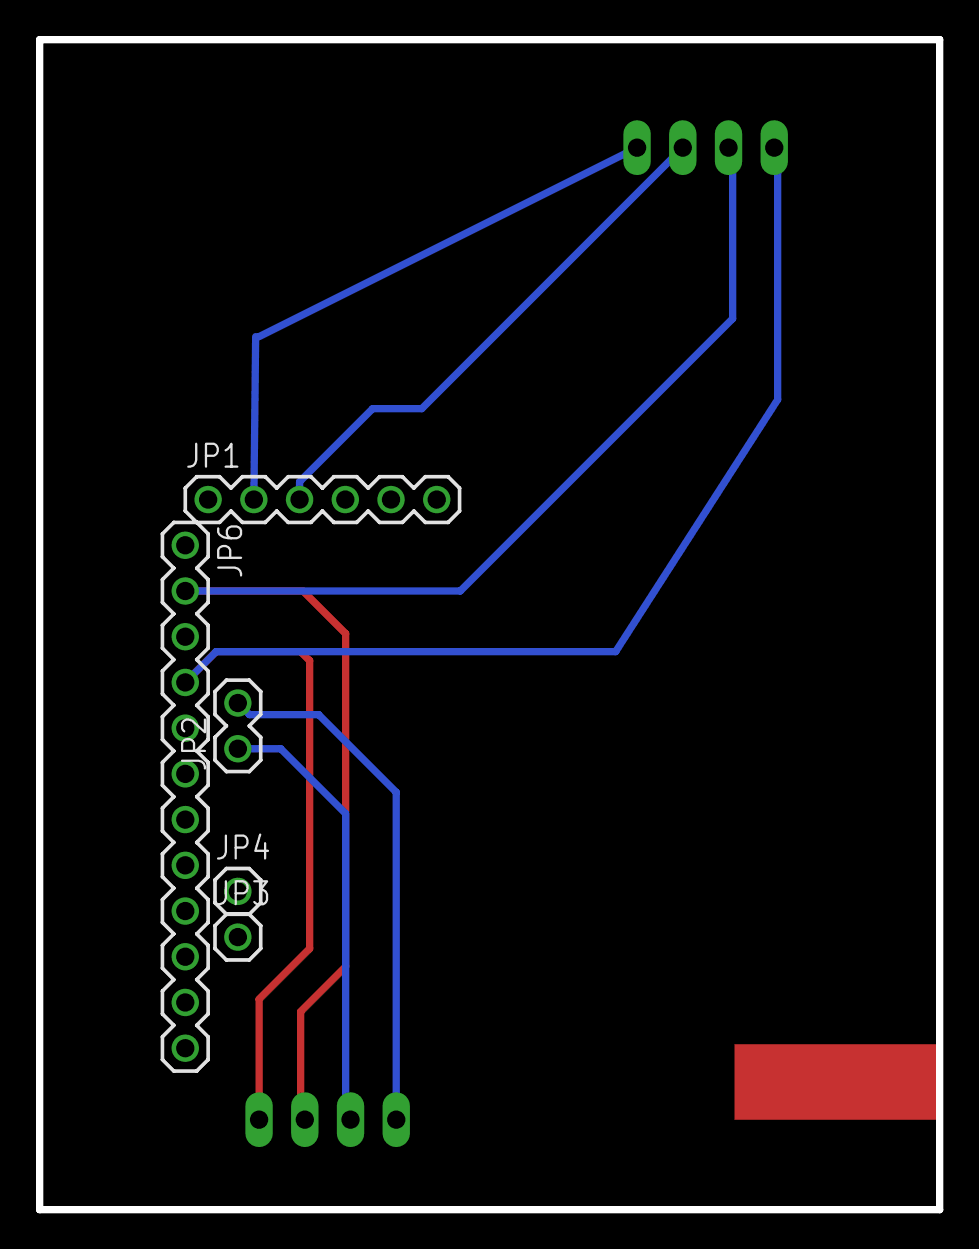
[picture p90: board box'.brd from below]

Board: 2 copper layers, 50.0 x 65.0 mm, 7 parts (5 on the bottom side), 5 nets.

Parts:
JP1: FTDI Basic; 1X06
JP2: 1X02
JP3, JP4: 1X01
JP6: 1X12
SV1, SV2: MA04-1

Connections:
S$2: JP1.3, SV1.3
S$3: JP2.2, SV2.4
S$4: JP2.1, SV2.3
S$5: JP6.2, SV1.2, SV2.2
S$6: JP6.4, SV1.1, SV2.1
