Furkannn/senior-design/PCB Design/box''/box''.brd

## EAGLE design PCB Design/box''/box''.brd (2013-04-11)

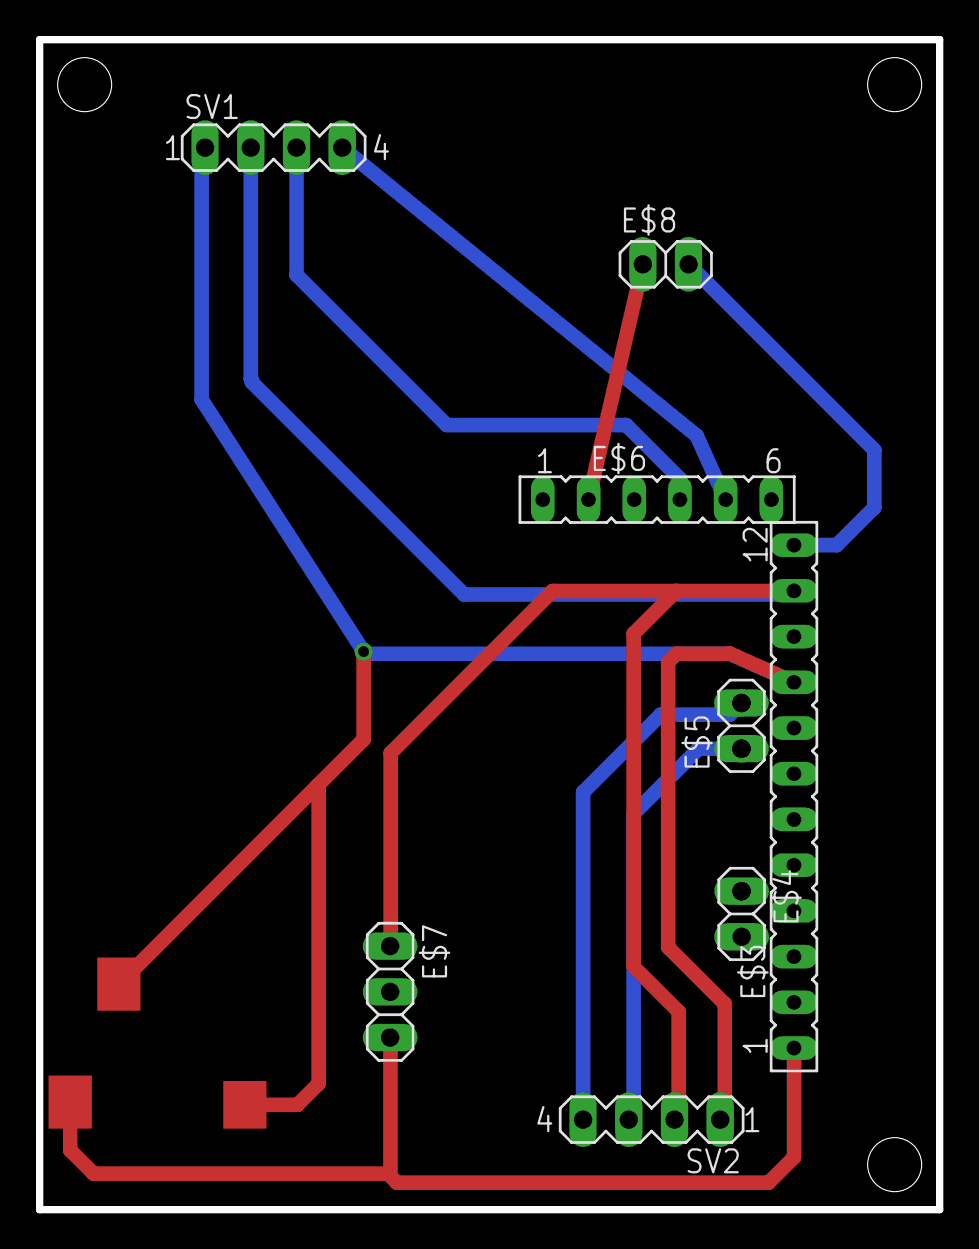
[picture p94: board box''.brd from above]

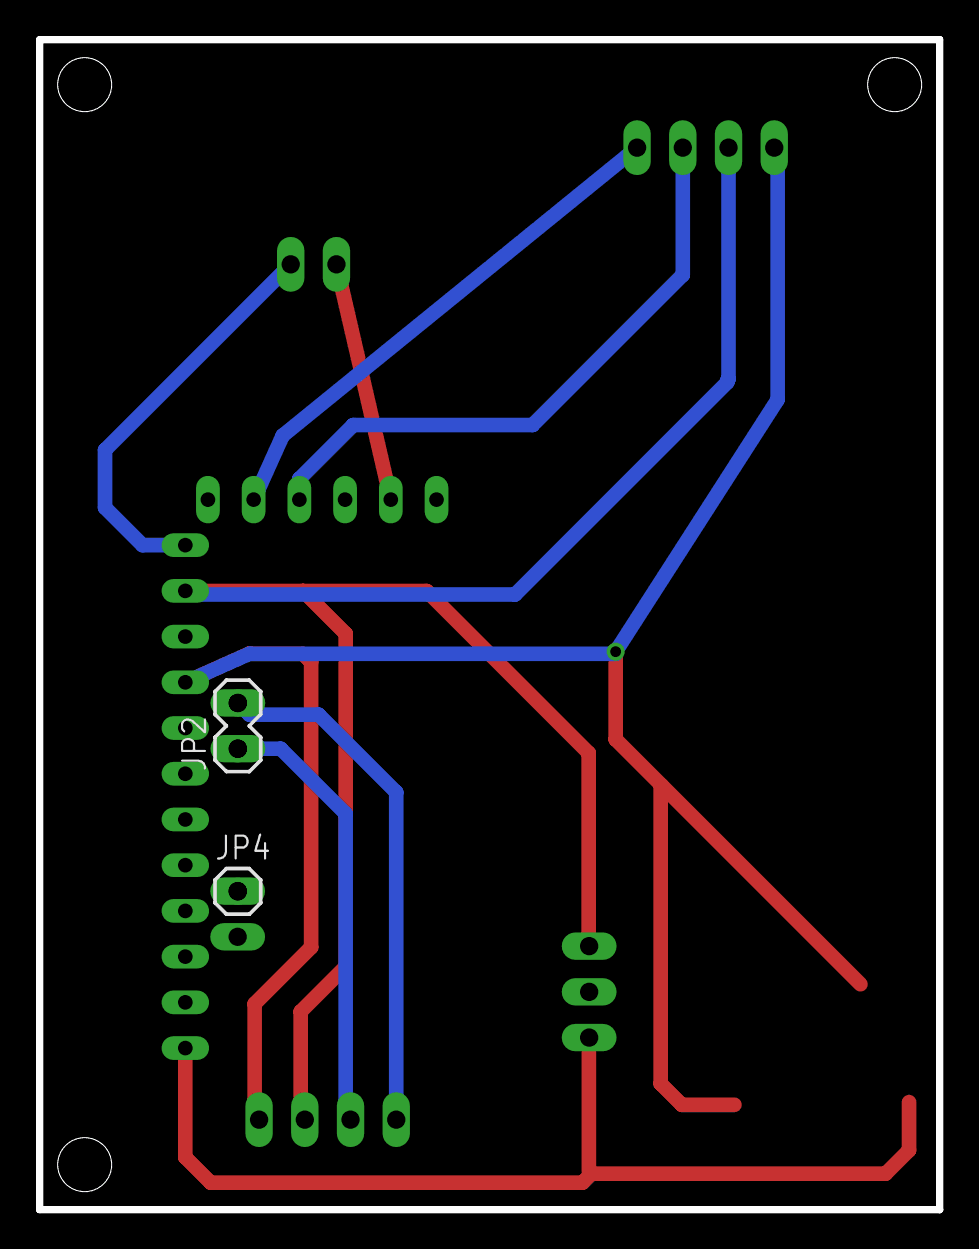
[picture p95: board box''.brd from below]

Board: 2 copper layers, 50.0 x 65.0 mm, 11 parts (2 on the bottom side), 7 nets.

Parts:
E$1: SMDAUDIO
E$3: FE12
E$4, E$5, E$8: 1X02
E$6: FE06
E$7: 1X03
JP2: 1X02
JP4: 1X01
SV1, SV2: MA04-1

Connections:
S$2: E$6.4, SV1.3
S$3: JP2.2, SV2.4
S$4: JP2.1, SV2.3
S$5: E$3.11, SV1.2, SV2.2
S$6: E$1.P$2, E$1.P$3, E$3.9, SV1.1, SV2.1
S$9: E$6.2, E$8.1
S$11: E$3.12, E$8.2
