Furkannn/senior-design/PCB Design/Box PCB/EagleBoardv2.brd

## EAGLE design PCB Design/Box PCB/EagleBoardv2.brd (2013-03-31)

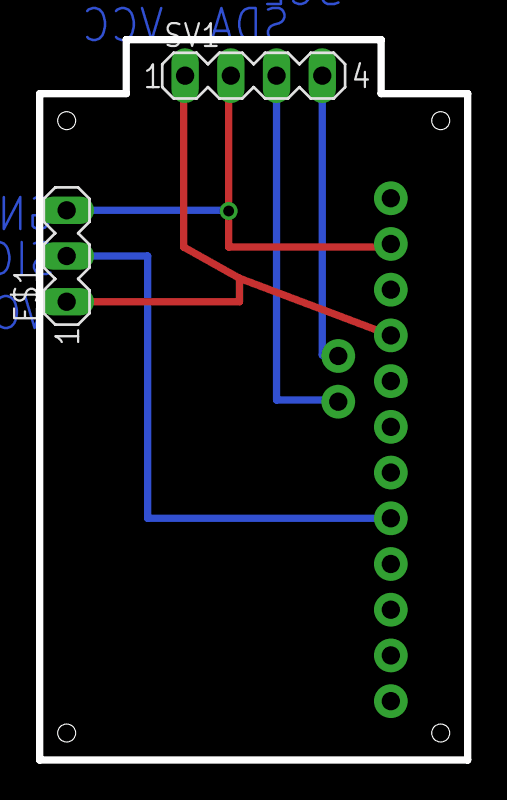
[picture p96: board EagleBoardv2.brd from above]

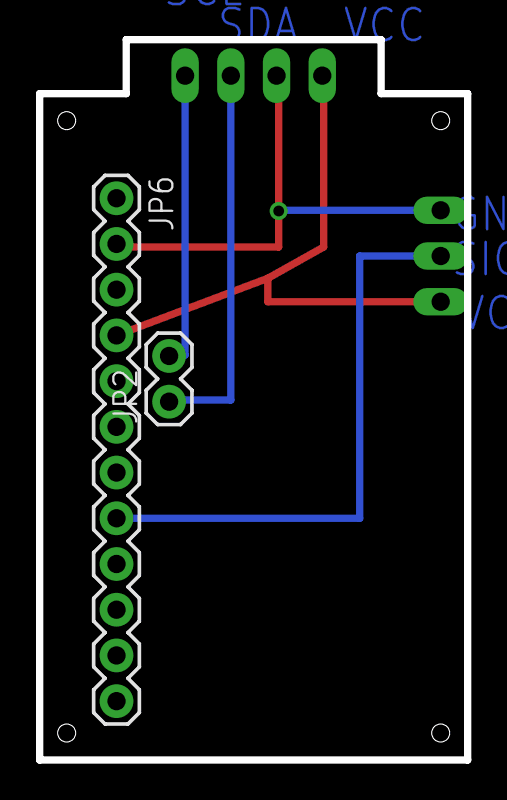
[picture p97: board EagleBoardv2.brd from below]

Board: 2 copper layers, 23.8 x 40.0 mm, 4 parts (2 on the bottom side), 5 nets.

Parts:
E$1: MA03-1
JP2: 1X02
JP6: 1X12
SV1: MA04-1

Connections:
S$2: JP2.1, SV1.3
S$3: JP2.2, SV1.4
S$4: E$1.1, JP6.4, SV1.1
S$5: E$1.2, JP6.8
S$6: E$1.3, JP6.2, SV1.2
