Furkannn/senior-design/Python Scripts/headMouse/MouseFSM_v2/launch_mouse_control.py

import MouseMotionFSMClass as mouseFSMClass
import os
import acd_file_io_lib as io
import time
import sys


def readParams():
  global lastModTime
  global params

  params = io.fetchYaml(paramsFilename)
  lastModTime = os.stat(paramsFilename).st_mtime
  print "Loaded new params: " + str(params)


def checkForNewParams():
  global lastModTime
  global params

  modTime = os.stat(paramsFilename).st_mtime
  if lastModTime != modTime:
    params = None
    while params == None:
      readParams()
    lastModTime = modTime
    return True
  return False



print "\n\n============    Head Tracking Log   ============"
io.writeMessage("Starting up...")
time.sleep(2)

# get paramters
paramsFilename = 'HeadTrackingParams.yaml'
readParams()
mouseFsm = mouseFSMClass.MouseMotionFSMClass(params=params)

while params['exit'] == 0:
  mouseFsm.step()
  if checkForNewParams():
    mouseFsm.updateParams(params)

print "TERMINATING  !!!"
