Furkannn/senior-design/Accelerometer Scripts/Accelerometer_FSM/FSM.pde

//================================================================================================
// Finit State Machine Parent Class
//================================================================================================

char state_; // current state
int timer_; // when we last switched
int switched_; // did we just switch?




// initialize finite state machine
void initFSM() {

  state_ = 'C';                       // start in CALIBRATION state
  int switched_ = 1;
  int timer_ = millis();
  printState(state_);
  
}




// Switch state and reset timer
void switchToState(char state) {

  state_ = state;
  switched_ = 1;
  printState(state_);
  timer_ = millis();
  
}




// do one time-step
void step() {
  int elapsed = millis()-timer_; // always include this 

  // state machine needs to define the two functions below !

  // Check for triggers that change state 
  checkTriggers(elapsed);

  if (switched_==1) {
    elapsed = millis()-timer_; // if we did change state, reset elapsed 
  }

  // now execute current behavior
  executeBehavior(elapsed);

  switched_ = 0; // always include this to reset this flag
}
