Furkannn/senior-design/(commit log)

2013-03-24 initial commit and python IMUSerial module completed
    [2013 Team Registration Form (ECE).xlsx, L23_Pricing_Worksheet.xls, OFSMount_v1.SLDPRT, OFSMount_v1.STL, OFSMount_v4.SLDPRT, OFSMount_v4.STL, OFSMount_v5.SLDPRT, OFSMount_v5.STL]
2013-03-24 serial and imu class complete
2013-03-26 solidworks files
    [Arduino.SLDPRT, ArduinoProMini.SLDPRT, CaseBottom.SLDPRT, CaseBottom.STL, CaseCover.SLDPRT, CaseCover.STL, CaseModel.SLDPRT, EarPlug.SLDPRT]
2013-03-31 working prototype of nod detection
    [Arduino-Pro-Mini-v13.brd, Arduino-Pro-Mini-v13.sch, Arduino.SLDPRT, ArduinoPro.brd, ArduinoProMini.SLDPRT, CaseBottom.SLDPRT, CaseBottom.STL, CaseCover.SLDPRT]
2013-04-01 fixed record training data file
    [acd_file_io_lib.py]
2013-04-02 completed train model convertion into class
    [Arduino.SLDPRT, ArduinoProMini.SLDPRT, CaseBottom.SLDPRT, CaseCover.SLDPRT, CaseModel.SLDPRT, EarPlug.SLDPRT, FullModel.SLDASM, Headphone Example.SLDPRT]
2013-04-03 working gesture recog
    [Arduino.SLDPRT, CaseBottom.SLDPRT, CaseBottom.STL, CaseCover.SLDPRT, CaseCover.STL, EarPlug.SLDPRT, FullModel.SLDASM, IMU.SLDPRT]
2013-04-06 trying to fix sudden bursts
    [Arduino.SLDPRT, ArduinoProMini.SLDPRT, BluetoothTransmitter.SLDPRT, CaseBottom.SLDPRT, CaseBottom.STL, CaseCover.SLDPRT, CaseCover.STL, CaseModel.SLDPRT]
2013-04-09 before restructuring mouse control code
    [Arduino-Pro-Mini-v13.brd, Arduino-Pro-Mini-v13.sch, BoxCover.SLDPRT, BoxCover.STL, EBoxAssembly.SLDASM, EagleBoardv2.brd, OuterBox.SLDPRT, OuterBox.STL]
2013-04-10 schematic and gui changes
    [box''.brd]
2013-04-19 project summary and changed ui to remove left and right buttons
2013-04-21 added calibrate flag
2013-04-21 configured train button and added messages
2013-04-22 try catch in the read message
    [ECE 4007 Spring_2013 Parts Checkout Return List - 2.xlsx, ECE 4007 Spring_2013 Parts Checkout Return List.xlsx, ECE4007_Spring_2013_Parts Purchase Return List - 2.xls, ECE4007_Spring_2013_Parts Purchase Return List.xls]
2013-04-23 now checks for bluetooth devices and works at 9600 baudrate
2013-04-25 non python related files
    [BoxCover.STL, BoxCover_final.SLDPRT, BoxCover_final.STL, EBoxAssembly_final.SLDASM, OuterBox.SLDPRT, OuterBox.STL, OuterBox_final.SLDPRT, OuterBox_final.STL]
2013-04-25 just tested with and without bluetooth. this shit worksgit statusgit status! Expo ETA - 3 hrs
    [ECE 4007 Spring_2013 Parts Checkout Return List - 2.xlsx, ECE4007_Spring_2013_Parts Purchase Return List - 2.xls]
